laraamy16/Audio-Power-Amplifier/Layout/layout.jpg

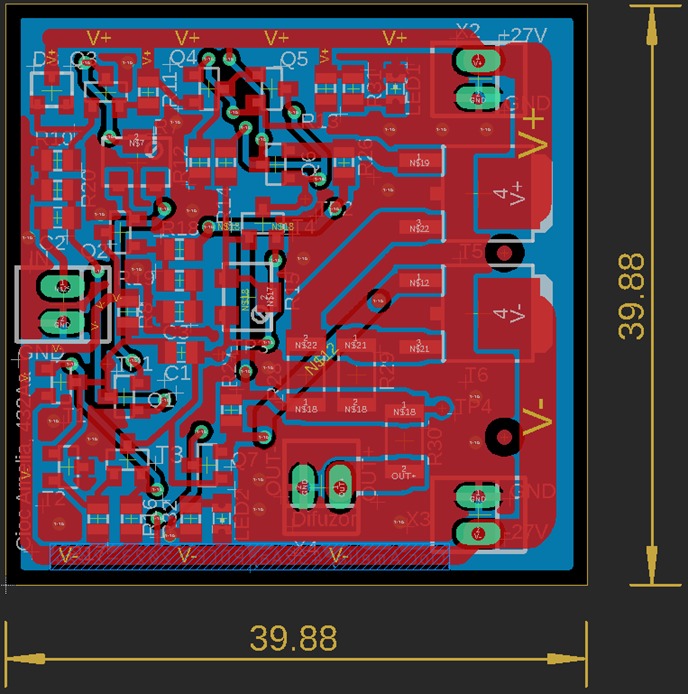
Layout/layout.jpg
