laraamy16/Audio-Power-Amplifier/Proiect docs/PCB.docx

Proiect Amplificator de putere

– Proiectare PCB cu componente SMD in EAGLE -

Cioc Amelia Gisele, Grupa 432Aa, PDCE I 2023-2024

Schema electrica amplificator de putere in Eagle:

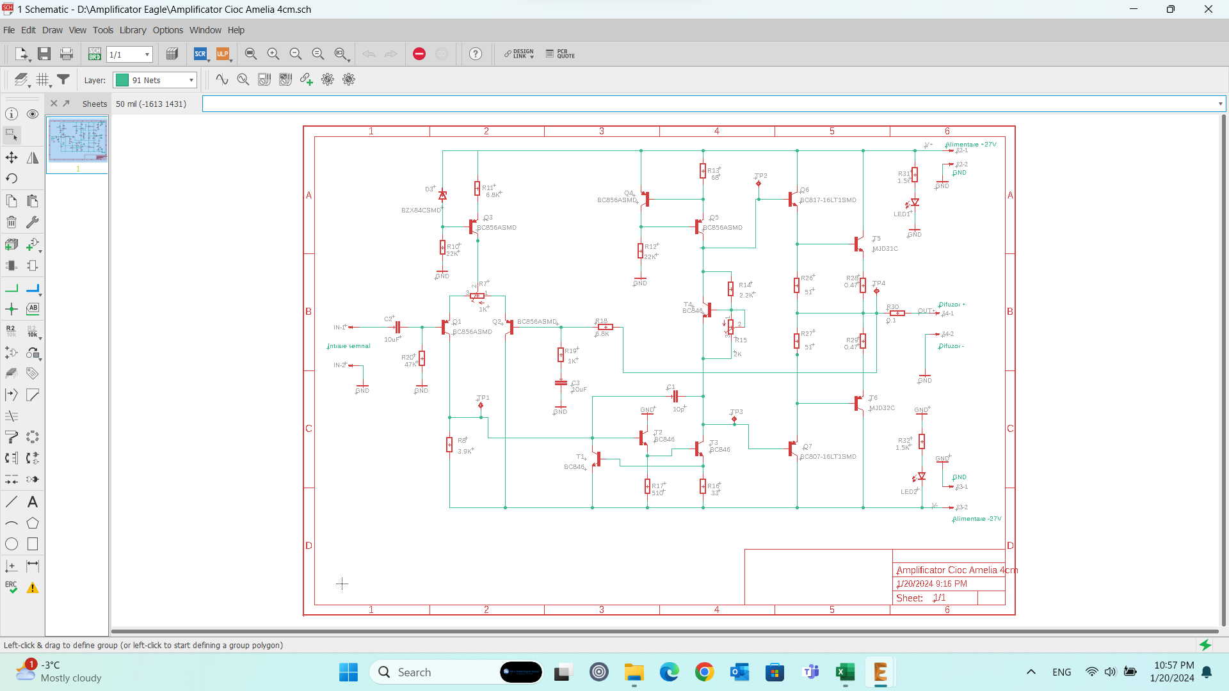
[picture p2: figure]

Schema electrica amplificator de putere

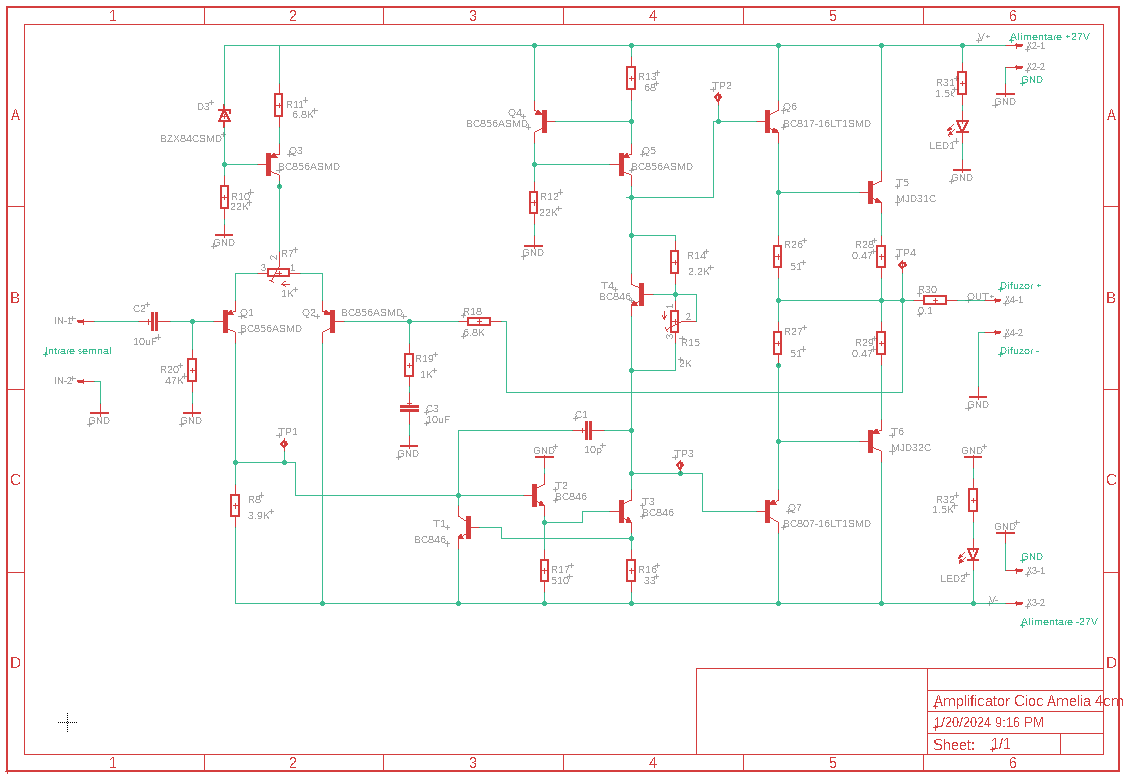
[picture p3: figure]

Rutare trasee PCB amplificator de putere in Eagle (dimensiuni in mm):

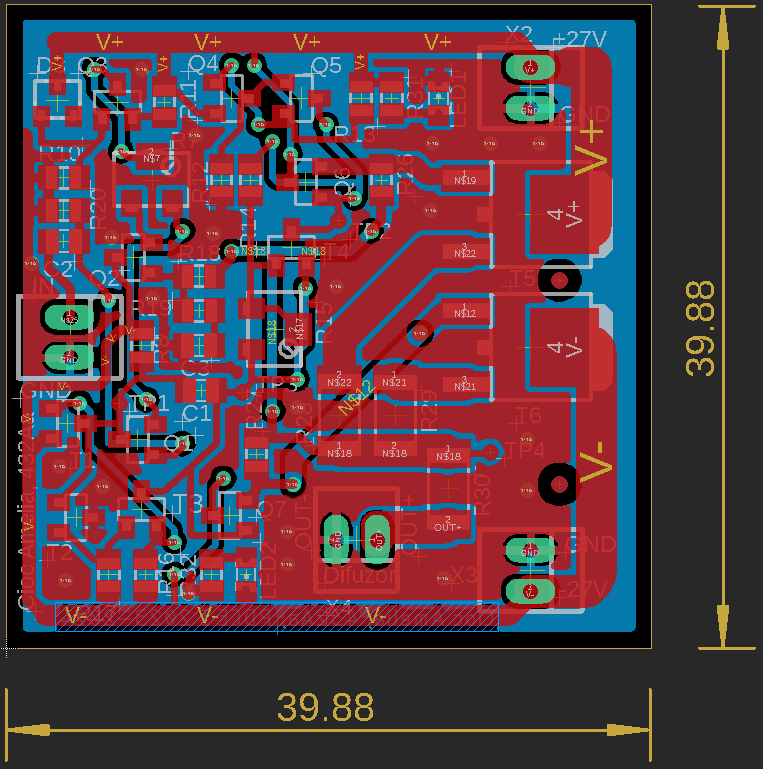
[picture p4: figure]

PCB amplificator - stratul top:

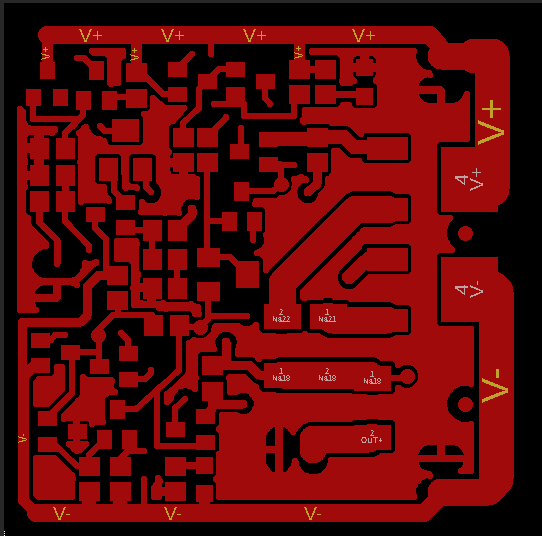
[picture p5: figure]

PCB amplificator - stratul bottom:

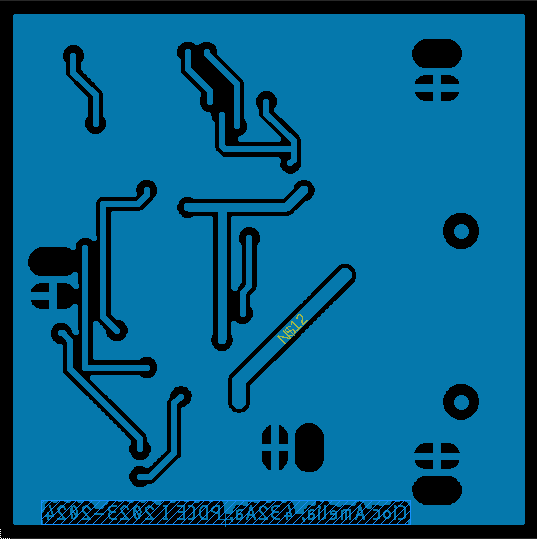
[picture p6: figure]
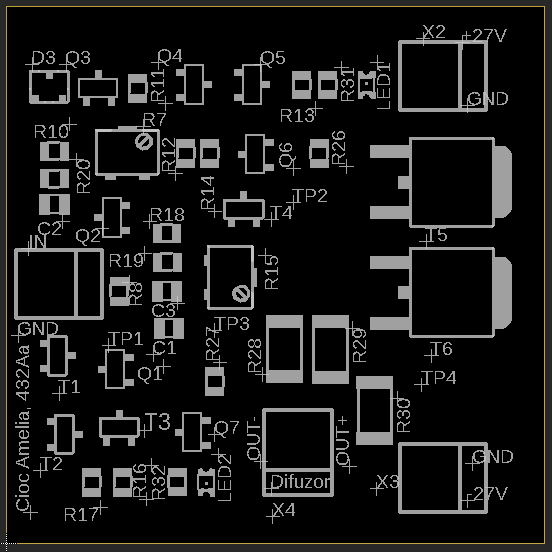
[picture p7: figure]

Amplasare si dimensiuni gauri si vias-uri

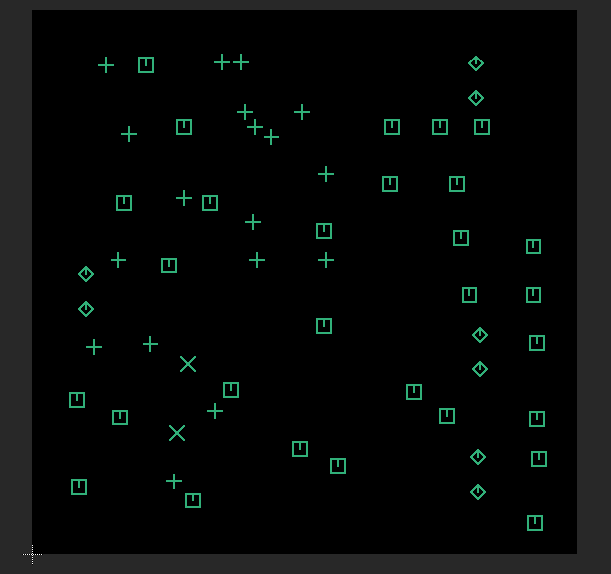
[picture p8: figure]
