laraamy16/Audio-Power-Amplifier/Tema2_N16_Amplificatorul_Audio_de_Putere.pdf

### Capitolul 2

### AMPLIFICATOR AUDIO DE PUTERE

Acest capitol prezintă principalele aspectele ale proiectării amplificatoarelor audio de putere. Se porneşte de la o temă de proiectare care stabileşte schema bloc a amplificatorului şi principalii parametri ai amplificatorului. După proiectarea etajului final, pilot, diferenţial, a protecţiei termice şi la scurtcircuit sunt analizate stabilitatea şi amplificarea stabilită de reţeaua de reacţie negativă.

### 2.1 TEMA DE PROIECTARE

Tema de proiectare se referă la un amplificator de audiofrecvenţă de mare putere realizat dintr-un etaj de ieşire în clasă B polarizat cu ajutorul etajului pilot care lucrează în clasă A. Pentru asigurarea unui curent mare de ieşire tranzistoarele finale sunt realizate din două tranzistoare în conexiune darlington.
Amplificarea în tensiune şi adaptarea cu sursa de semnal de intrare este realizată cu ajutorul etajului de intrare de tip diferenţial care lucrează de asemenea în clasă
A. Amplificarea globală a amplificatorului este stabilită prin intermediul reacţiei negative.

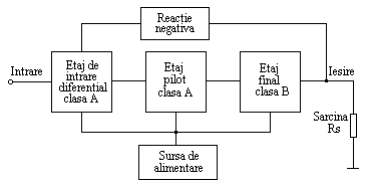
[picture p21: figure]

Figura 2.1-1. Schema bloc a amplificatorului audio de putere

24 | Proiectarea circuitelor electronice de audiofrecvenţă

### 2.2 SETURI DE DATE DE INTRARE

Principalii parametri ai amplificatorului audio de putere sunt:
- Puterea nominală pe sarcină PS (W)
- Rezistenţa de sarcină Rs (Ω)
- Rezistenţa de intrare Ri (KΩ)
- Amplificarea în tensiune AV (-)

Sursa de alimentare va asigura următorii parametri:
- Curentul maxim I0M (A)
- Rezistenţa de ieşire maximă R0M (Ω)
- Tensiunea de alimentare este 220Vac ± 10%

Tabelul 2.2-1. Seturi de date de intrare pentru proiectare
Nr. | Amplificator | Sursă de alimentare
PS (W) | Rs (Ω) | Ri (KΩ) | AV (-) | I0M (A) | R0M (Ω)
1 | 60 | 2 | 30 | 8 | 7,7 | 2,6
2 | 60 | 3 | 35 | 9 | 6,3 | 3,8
3 | 60 | 4 | 40 | 10 | 5,5 | 4,9
4 | 60 | 5 | 45 | 11 | 4,9 | 6,0
5 | 50 | 3 | 30 | 12 | 5,8 | 3,9
6 | 50 | 4 | 35 | 8 | 5,0 | 5,0
7 | 50 | 5 | 40 | 9 | 4,5 | 6,1
8 | 50 | 6 | 45 | 10 | 4,1 | 7,2
9 | 40 | 4 | 30 | 11 | 4,5 | 5,1
10 | 40 | 5 | 35 | 12 | 4,0 | 6,3
11 | 40 | 6 | 40 | 8 | 3,7 | 7,4
12 | 40 | 7 | 45 | 9 | 3,4 | 8,5
13 | 30 | 5 | 30 | 10 | 3,5 | 6,4
14 | 30 | 6 | 35 | 11 | 3,2 | 7,6
15 | 30 | 7 | 40 | 12 | 2,9 | 8,7
16 | 30 | 8 | 45 | 8 | 2,7 | 9,8
17 | 20 | 6 | 30 | 9 | 2,6 | 7,9
18 | 20 | 7 | 35 | 10 | 2,4 | 9,1
19 | 20 | 8 | 40 | 11 | 2,2 | 10,2
20 | 20 | 9 | 45 | 12 | 2,1 | 11,4

Amplificator audio de putere | 25

Setul de date utilizate pentru exemplificare

Pentru proiectarea etajelor amplificatorului audio de putere a fost utilizat setul de parametri următor:

Tabelul 2.2-2. Setul de date utilizate pentru exemplificare
Nr. | Amplificator | Sursă de alimentare
PS (W) | Rs (Ω) | Ri (KΩ) | AV (-) | I0M (A) | R0M (Ω)
3 | 60 | 4 | 40 | 10 | 5,5 | 4,9

### 2.3 ETAJUL FINAL

Este realizat cu două tranzistoare bipolare complementare în conexiune colector comun. Deoarece tehnologia bipolară este axată pe tranzistore de putere de tip npn şi pentru creşterea amplificării în curent a etajului final se utilizează pentru cele două tranzistoare finale de putere configuraţii darlington de tip npn şi pnp.

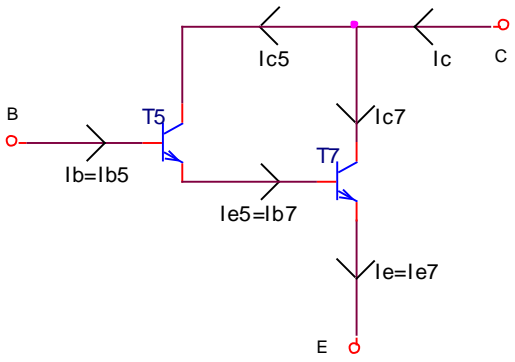
[picture p22: figure]

Figura 2.3-1. Configuraţie darligton de tip npn

Considerăm T5 şi T7 în regim activ normal RAN.

VBE = VBE5 + VBE7 > 0
>0 >0

VCE = VCE7 = VCE5 + VBE7 > 0

Pentru ICB0 = 0 =>

Ic= Ic5 + Ic7 = βF5 IB5 + βF7 IB7 = βF5 IB5 + βF7 IE5 =

=> RAN

26 | Proiectarea circuitelor electronice de audiofrecvenţă

=
I | I C

F

F
F | B | F | 5
7

7
5 | 5 | 7

1
β

β
β β

+
+ | =
I | F I B

F

F
F | B | F | 5 | 5
7

7
5 | 5 | 7
| | 1
β | β | β
| | β

β +
+ | =

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
æ | +
+
| 7

7
5 | 5 | 7

1
1

F

F

F I B | F | β β
β | β | =
÷

÷
ø

ö
ç

ç
è
æ | +
+
| 7

7
5 | 7

1
1

F

F
F I B | F | β

β
β | β

÷

÷
ø

ö
ç

ç
è
æ | +
= | = | +

7

7
5 | 7

1
1

F

F
F | F
B

C
F
I

I
β

β
β | β | β | ≈ β ( β ) 5 | 7
1
F | F
+ | ≈ β F5 β F7
·

Principalii parametri ai configuraţiei Darlington de tip npn sunt:

βF ≈ βF7 βF5 = mare | avantaj

I

V V
I

V
h

B

BE | BE

B

BE

5

5 | 7
11

+
= | = | = h11T 5 + (1+ β F5

)h11T 7
= mare | avantaj
VCE, Saturaţie = VCE7, Saturaţie = nu se modifică | avantaj
VBE = 2VBE5 = 2VBE7 = mare | dezavantaj

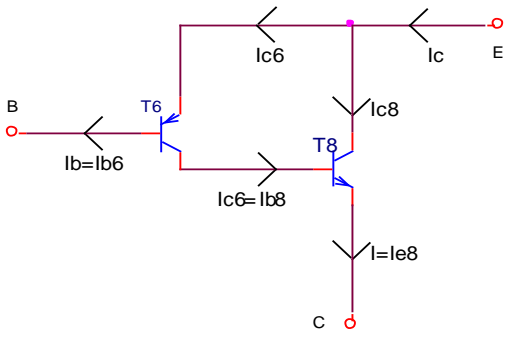
[picture p23: figure]

Figura 2.3-2. Configuraţie darligton de tip pnp

Considerăm T1 şi T2 in RAN.

VEB = VEB6 > 0

VEC = VCE8 = VEC6 + VBE8 > 0

Pentru ICB0 = 0 =>

IC = IE8 = ( βF8 + 1 ) IB8 = ( βF8 + 1 ) IC6 =

= ( βF8 + 1 ) βF6 IB6 = ( βF8 + 1 ) βF6 IB

=> RAN

Amplificator audio de putere | 27

βF =

B

C
I

I
= ( βF8 + 1 ) βF6 ≈ βF8 βF6

Principalii parametri ai configuraţiei Darlington de tip pnp sunt:

βF ≈ βF8 βF6 = mare | avantaj
h11 = h116 = nu se modifică | avantaj
VEB = VEB6 = nu se modifică | avantaj
VEC = VCE8 = VEC6 + VBE8 = mare | dezavantaj

Când T6 se saturează se pierde controlul lui IC6 prin IB6 iar IC6 se închide prin joncţiunea BE a lui T8 care rămâne în RAN. =>

VEC, Saturaţie = VEC6, Saturaţie + VBE8 = 0,2 + 0,6 = 0,8V

Tehnologia bipolară standard este orientată pe fabricarea tranzistoarelor de tip npn care au conducţie verticală şi au factorul de amplificare în curent βF = mare (100 ÷ 200). Tranzistoarele pnp sunt de tip lateral cu conducţie orizontală sau tranzistor de substrat cu conducţie verticală având βF mic.

În practică se folosesc configuraţiile darlington cu rezistenţă în paralel cu joncţiunea bază-emitor a tranzistorului bipolar de putere de tip npn (R26 şi R27). Rolul acestor rezistenţe este următorul:
- La funcţionarea în clasă „B” în repaus curentul prin T7 este mic iar curentul de baza va fi şi el mic. La curenţi mici de colector pentru T5 amplificarea în curent a tranzistoarelor are o cădere pronunţată Þ amplificarea este redusă Þ reacţia negativă va fi ineficientă asupra neliniarităţii curbei de transfer.
- La îmbinarea caracteristicilor tranzistoarelor complementare apar distorsiuni de trecere (cross-over) şi pentru micşorarea acestora se face o polarizare iniţială în regim static al tranzistoarelor. Rezistenţa R26 măreşte curentul de colector al tranzistorului T5 în regim de repaus deoarece la IC7 mic, h11,T7 e foarte mare şi cea mai mare parte a curentului dat de T5 trece prin R26 şi astfel T5 lucrează la curenţi acceptabili cu βF5 suficient de mare. La curent de colector mare pentru T7, h11T7 scade exponenţial şi R26 se poate neglija.
- Rezistenţa R26 permite evacuarea sarcinii stocate prin circulaţia unui curent invers de bază în perioada corespunzătoare blocării Þ R26 îmbunătăţeşte funcţionarea la frecvenţe înalte, dar nu elimină efectele dacă frecvenţa de lucru e mai mare ca fβ.

28 | Proiectarea circuitelor electronice de audiofrecvenţă

Puterea disipată de tranzistorii finali T7,T8

Puterea maximă ce se poate obţine la ieşire este:
C CM P = E · I
0
EC este tensiunea de alimentare pentru un tranzistor final ICM este curentul de colector maxim al tranzistorilor finali

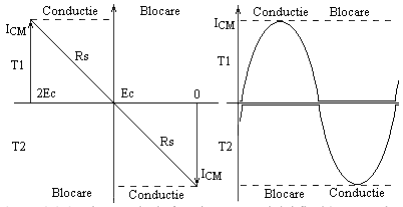
[picture p24: figure]

Figura 2.3-3. Diagramele de funcţionare a etajului final în contratimp

Puterea absorbită de la sursa de alimentare este:
a | C | med P = 2E · I
Imed este curentul mediu absorbit de la sursă
Imed = | ò
·

/ 2

0

2

sin 1

T
CM | tdt
T | T
k | I

π
= k
π

I CM

k este factorul de utilizare a tensiunii de alimentare

0 | 636 | 0 0,

2
2 | 2 | P | k P
I | k
P | E | I | E | k

CM
a | C | med | C = | · | = | · · | = | · | = | · ·
π | π
Puterea nominală pe sarcină are expresia:

0

2 | 2 | 2 | 2
0,5
2

1
( )
2

1
PS

= · RS

- k · ICM

= · RS

- k · I CM = · k · P

RS este rezistenţa de sarcină

Puterea disipată de tranzistorii finali este:

0

2
( | )
(0,636 | 0,5 )
7 | 8

Pd T +T

= Pa − Pu

= | k − | k · P

Randamentul

| | k
| k P
k | P
P

P

a

S
= ·
- ·
- ·
= | = | 0,785
0,636

0,5

0

0

2
η

Derivând expresia puterii disipate de tranzistorii finali în raport cu k Þ puterea disipată maximă pe tranzistorii finali

Pd max(T 7+T8)
la k=0,636.

Pentru

k = 0,636
Þ

Amplificator audio de putere | 29
0 | 0
2 | 2 Pd max(T 7+T8) = [0,636 − 0,5·(0,636) ]· P = 0,2· P

Pentru un singur tranzistor final

0

2
max 7, 8
(0,636 | 0,5 | )
2

1
Pd | T T
= · | · k − | · k · P
, pentru k=0.636 Þ
max 7, 8 | 1 0 Pd | T T
= 0,
- P

Dimensionarea componentelor etajului final

Pentru dimensionarea componentelor etajului final se impun condiţiile:
- Puterea nominală pe sarcină PS la o frecvenţă convenabilă, respectiv 1kHz (din setul de date utilizate pentru exemplificare PS =60)
- Impedanţa de sarcină nominală la 1kHz are caracter predominant rezistiv RS (din setul de date utilizate pentru exemplificare RS =4Ω)
1. Determinarea valorilor de vârf ale curentului şi tensiunii pe sarcină

A
R

P
I
I | R | I V
P

S

S
S
S | S | S | S
S | 5,4
4
2 | 2 60
2 | 2

2
=

·
=
- Þ =

·
=

·
=

VS = RS

·I S= 4Ω·5,4A = 21,92V ≈ 21,6V

2. Se admite o pierdere de putere de maxim 10% pe rezistenţele de emitor R28 şi

R29

R28 = R29 = 0,39Ω
< 0.1 X 4Ω
toleranţă

±
5%

Căderea maximă de tensiune pe R28,R29 este
VR | VR | R28 | I
S | 2,1V
28 | 29
= | = | · | =

W

I V
P
S | R
dR | R | 2,9
4

28
28, 29 | =

·
= | (valoare medie, T7,T8 lucrează

în clasă B). Se aleg R28 şi R29 de 3W.

3. Se alege rezistenţa pentru circuitul de protecţie la suprasarcină

R30 = 0,1Ω

VR30 = R30

·I S = 0,5V

W

I V
P
S | R
dR | 1,5
2
| 30
30 | =

·
=
Se alege R30 de 2W.

30 | Proiectarea circuitelor electronice de audiofrecvenţă
4. Se aleg tranzistorii finali

S-a optat pentru tranzistori finali bipolari de putere de tip BDY 26 (183T2) având următorii parametri:

Ptot

= 87,5W

| VCE0,VCER = 180V | IC = 6A
h21E= 20÷180 (la IC=2A) | VBE < 1V | VCES = 0,6V
fTmin < 10MHz

Ptot este puterea totală disipată
VCE0 este tensiunea colector emitor cu baza în gol
VCER este tensiunea colector emitor cu rezistenţă specificată între bază şi emitor
IC este curentul de colector
h21E este factorul de amplificare în curent static în conexiunea emitor comun
VBE este tensiunea bază emitor
VCES este tensiunea colector emitor în saturaţie
fTmin este frecvenţa de tăiere minimă
5. Verificarea la străpungere a tranzistorilor finali

EC ≤ 0,9VCER , EC = 27V ≤ 162 = 0,9 VCER

6. Determinarea tensiunii reziduale pe darlingtonul npn

Vrez = VCEST5 + VBET7max
În cazul cel mai defavorabil:

mA

I | I | A
I
| T T

S

T T

CT T
T T | BT T | 270
20

5,4
20
7, 8 | 7, 8

7, 8
7, 8 = | Þ | 7, 8 = | = | = | =
β | β

β

În funcţie de IBT7,T8 se aleg T5 şi T6 (BD 139, BD 140) Pentru BD 139, VCEST5 ≈ 0,5V Þ Vrez = 0,5 + 1 = 1,5V

7. Determinarea tensiunii de alimentare

EC ≥ VS + VR30 + VR28 + Vrez = 25,7V = EC’ Se alege EC = 27V > EC’

8. Calculul energetic al tranzistorilor finali

P0 = EC

·ICM = EC

·I S =145W

0,95
27

25,7

'
= | = | =

C

C
E

E
k

Amplificator audio de putere | 31

Pa

= 0,636· k · P0 = 87,6W

PS

k | P | 65,4W
2

1

0

2
= · | · | =

Pd = Pa − PS = 22,2W

(Puterea disipată pe T7 si T8 )

Puterea disipată pe un tranzistor final este maximă pentru k=0,636 este

Pd max T7

= Pd max T8

= 0,1· P0 =14,5W
În cazul nostru pentru k=0,95 puterea disipată pe un tranzistor final este PdT7,T8 = 0,5 ( 0,636k – 0,5 k²
) P0 = 11W
η = 0,785· k = 0,75

9.Dimensionarea rezistenţelor R26 ,R27

Se aleg R26 ,R27 = 39Ω, toleranţă

±
5%

ICMT5 = IBMT7 + IR26 = IBMT7 +
R

V BEMT

26

7
= 270mA +
39Ω

1V
≈ 300mA

ICMT5 este curentul de colector maxim al tranzistorului T5 IBMT7 este curentul de bază maxim al tranzistorului T7 VBEMT7 este tensiunea bază emitor maximă a tranzistorului T7

10. Estimarea sarcinii dinamice pentru T5,T6

RST5 = [ h11T7 + βT7 ( RS + R30 + R28 ) ] ║
R26

h11T7 =

7

7

BT

BEMT
I

V
≅ 3,3 Ω

RST5 = ( 3,3 + 20 · 4,49 ) ║ 39 = 27,5 Ω

11. Calculul energetic al tranzistorilor complementari

P0 = ICMT5 · EC = 0,3 · 27 = 8,1W

Pd max

= 0,1P0 = 0,81W
Tranzistoarele BD 139 şi BD 140 corespund, având următorii parametri:
VCE0 = 80V | IC =1A | Ptot= 12,5W
VCER = 100V | ICM =1,5A | fT = 50MHz
VEB0 = 5V | IB =0,2A | Rthj-C ≤ 10°C
h21E = 50÷200 | Tj =150°C

32 | Proiectarea circuitelor electronice de audiofrecvenţă
12. Calculul frecvenţei de tăiere

ωT

= β 0
·ωβ Þ
Pentru T7 şi T8 | f ≥100 ÷500kHz β
Pentru T5 şi T6 | f ≥ 0,35 ÷1,25MHz β

### 2.4 ETAJUL PILOT

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
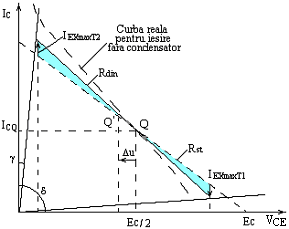
[picture p25: figure]

Figura 2.4-1. Configuraţia | Figura 2.4-2. Caracteristica de ieşire
etajului pilot | a etajului pilot

Etajul pilot, conform cu Figura 2.4-1. este de tip emitor comun EC şi lucrează în clasă A. Pentru utilizarea completă a sursei de alimentare a circuitului de putere este necesară o tensiune de excitaţie vârf la vârf mai mare ca tensiunea de alimentare Vex,vv > EC, condiţie greu de realizat.
În figura 2.6
Rsat tgγ = şi

Rrez tgδ =
, definite în raport cu ICER. Se observă că în cazul real excursia tensiunii Vex,vv este mult mai mică decât EC şi asimetrică.
K1 şi K2 sunt coeficienţii de utilizare ai tensiunii de alimentare pentru tranzistorul T1 respectiv pentru tranzistorul T2.
În schemele cu ieşire pe condensator, datorită inegalităţii dintre K1 şi K2 (în general K1 < K2) apar distorsiuni la nivele mari şi apare o componentă continuă (Δu) ce deplasează punctul static de funcţionare (PSF-ul) în sensul egalizării factorului de utilizare, Figura 2.4-2.. În schemele în care ieşirea nu se face pe condensator, ca în cazul acestui proiect, apare o curbură a caracteristicilor. Soluţia poate fi folosirea unei tensiuni de alimentare a etajului pilot

Ep > Ec
, fapt
ce conduce la complicarea sursei de alimentare sau la soluţia de bootstrapare a rezistenţei RC.

Amplificator audio de putere | 33

Ec /2

Rs

Ec /2

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
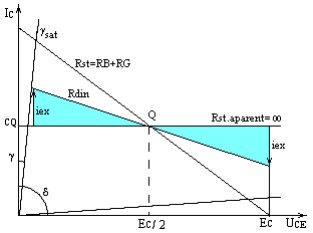
[picture p26: figure]

Figura 2.4-3. Bootstraparea | Figura 2.4-4. Caracteristica de ieşire
rezistenţei de colector a etajului pilot | a etajului pilot bootstrapat

Pentru acest montaj se poate considera:
- În regim static rezistenţa de alimentare este

Rst

= Rc

= RB + RG
- În regim dinamic ZS pentru etajul pilot este Rdin.
- În regim dinamic rezistenţa aparentă de alimentare este Rst a = ∞ şi sursa are

valoarea

E C = ∞

'

Avantajele utilizării acestei soluţii sunt următoarele:
- Excursia curentului se limitează la
VV | ex | CQ I | = 2· I < 2· I
- Deoarece
CQ | ex I | > I
, această soluţie este avantajoasă pentru uşurarea regimului termic al etajului pilot.
- Se obţine astfel
1 | | | 2

k ≈ k

Condiţia de funcţionare a schemei este ca rezistenţa dinamică Rdin > RC = RB + RG

Dimensionarea componentelor etajului pilot

1. Se calculează curentul de excitaţie maxim

mA

I | mA I | I

T

CT
ex | BT | 6
50

300

min

max
max | max

5

5

5

= | = | = | =
β

Se pot neglija curenţii reziduali şi se alege

ICT3 = ICQ

= 8mA
>

I ex max

= 6mA

34 | Proiectarea circuitelor electronice de audiofrecvenţă
2. Rezistenţa statică de alimentare
= | + | = | + | = | = | = | KΩ
mA

V
I

E
R | R | R | R | R

CT

C
C | B | G | 3,375
8

27

3

13 12

Alegem

R12 = 360Ω
si

R 3k 13 =

3. Sarcina dinamică a pilotului

( ) 30

11

'
13

13
21
13 | 11
13 | 11

6
6

6
1 | R | R
R | h

R
h
R | h
R | h
R | S

T

E
T

T
din | f

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
+ | + | ·
+

·
≈

unde h11T6 =
40 8

40

6

6
·

=
gmT

β T
= 125Ω şi

h21Ef = h21T6 · h21T8 = 50 · 20 = 1000

( | ) 11 | 21 | 29 11
'
1

6

h 6 | h | h | R T | Ef
T = | + + | ·
= 125 + ( 1+1000 ) · 0,39 = 515Ω

Þ

÷· | ≈ | Ω
ø

ö
ç
è

æ
+ | + | ·

·
Rdin = | 4,1 3,6K
3,515

3
1 1000
3125

3000 125

Se verifică

Rdin = 3,6kΩ > RB + RG = 3,36KΩ

4. Tensiunea minimă pe tranzistorul pilot

Vpmin =VBE min,T8 +VCEmin,T 6

= 0,6 + 0,2 = 0,8V

5. Alegerea tranzistorului pilot

Pentru o funcţionare cât mai bună a bootstrapului se alege un tranzistor cu VCEsat şi ICER mici.
Se alege BD 139 cu parametri:
VCE0 = 80V | IC =1A | Ptot= 12,5W
VCER = 100V | ICM =1,5A | fT = 50MHz
VEB0 = 5V | IB =0,2A | Rthj-C ≤ 10°C
h21E = 50÷200 | Tj =150°C

La IC = 2·ICQ = 16mA → VCesat = 0,6V şi ICER = 0,2mA

Tensiunea ce trebuie preluată de R15 este

Amplificator audio de putere | 35
= | − | = | − | = | Þ | ≅ | = | = 25Ω
8

0,2
0,8 0,6 0,2

15
15 | min | , 3 | 15 | mA

V
I

V
V | V | V | V | R

CQ

R
R | p | CEsat T

Calculele impun alegerea lui R15 = 27Ω cu toleranţă de 5%

6. Curentul de baza al tranzistorului T3

Considerând h21E mediu,T3 = 100 Þ

A

mA IBT | 80µ
100

8
3 = =
7. Verificarea funcţionării la semnal mic
= | = | =

CQ

ex

m

C
BE | I

I
g

I
40

µ
0,024V =24mV < 26mV =
q

KT

8. Amplificarea în tensiune a etajului pilot

Etajul pilot este de tip emitor comun cu sarcină distribuită având amplificarea în tensiune:

133
27

3,6

15

= −
Ω

≈ − = −

k
R

R
A

din
vp
9. Calculul frecvenţei de tăiere

ωT

= β 0
·ωβ Þ | f | MHz T | 0,35...1,25
3 β | ≥
10. Calculul circuitului de polarizare al tranzistorilor finali

Circuitul de polarizare este alcătuit din tranzistorul T4 (superdiodă) şi potenţiometrul R14. Se consideră necesar pentru deschiderea tranzistorilor finali o tensiune de 2 × 0,7V.
Pentru tranzistorul T4 alegem tipul BC 107A având următoarele valori limită absolute:
VCE0 =50V | IC = 100mA | IB = 50mA
Ptot = 300mW | | | Tj = 175°C

În PSF tranzistorul T4 are următorii parametri:

IC,T 4 = 8mA | VCE,T 4 ≅ 1,4V | A

mA
h

I
| | | I

E T

C T
B T | 36µ
220

8

21 , 4

, 4 Þ , 4 = | ≅ | =

36 | Proiectarea circuitelor electronice de audiofrecvenţă

Se alege prin divizorul de bază curentul:

≅ | >> | Þ | = | + | = | = | kΩ
mA

V
I
d | mA | I B T | R | R | R | 2,8
0,5

1,4
0,5 | , 4 | 14 | 1 | 2

Se alege R14 = 2,5kΩ.

### 2.5 ETAJUL DIFERENŢIAL

Etajul diferenţial este alcătuit din două tranzistoare în conexiune EC care lucrează în clasă A şi sunt cuplate diferenţial. Componentele acestui etaj sunt următoarele:
- Tranzistoarele T1 ,T2
- Rezistentele R6, R8, R9, R11, R31 şi D1, R7

Principalele funcţii ale acestui etaj sunt:
- Obţinerea unei impedanţe de intrare convenabile.
- Reglează echilibrarea stării de repaus (în absenţa semnalului) a întregului amplificator de putere
- Permite cuplarea reţelei de reacţie negativă

Dimensionarea componentelor etajului diferenţial

1. Alegerea tranzistoarelor T1,T2

Tranzistoarele T1, T2 se aleg de tipul BC178 şi se împerechează (se sortează două tranzistoare cu caracteristici cât mai apropiate). Aceste tranzistoare au următoarele valori limită absolute:
VCE0 =30V | IC = 100mA | IB = 50mA
Ptot = 300mW | Tj = 175°C
2. Dimensionarea rezistenţei de colector a tranzistorului T1 (R11)

Se alege

RCT1

= R11 < ZinT3min ZinT3min | h11eT3 min | h21eT3
R15 = | + | ·

IB,T3max ≅
h

CT I

21Emediu,T3

2 3
=
100

2 ·8
= 160µA
IC,T3min ≅ IB,T3max = 160µA | Þ

gm,T 3min
= 40 · IC,T3min = 6,4 Þ

h11,T3min =
g m T

T

, 3min

β 3min
=
6,4

50
= 7,8K ≅ 8K

Amplificator audio de putere | 37

Þ

ZinT3min | h11eT3 min | h21eT3
R15 = | + | ·
= 8K + 100·0,027K ≅ 11K

Pentru polarizarea bazei lui T3 trebuie ca :

, 1 | , 3 | 11 | 3 | 15 ( | ) C T | B T | R | VBET | VR
I | − I | · | = | +
≅ 0,7V + 8mA·27Ω ≅ 0,92V

Din motive de zgomot, pentru a avea factorul de zgomot F = 3dB trebuie ca:

ICT1 ≤ 300µA | Se alege ICT1 = ICT2 = 250µA

Þ

K
mA

V
I I

R

C T | B T

5,4
170

0,92
250 80
0,92 | 0,92
, 1 | , 3
11 | = | =
−

=
−

≈

Se alege R11 = 5,6K cu toleranţă de ±5%.

3. Verificarea funcţionării la semnal mic

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
BE T | 8
40 250 | /

80
40 , 1

, 1

, 1

, 1
, 1 | =
·

=
·

= =
µ

µ

4. Determinarea tensiunii stabilizate de D1

Pentru a simula generatorul de curent din emitor trebuie ca tensiunea stabilizată VZ

>> vBE,T1.
Deoarece
BT1

I
e foarte mic, se poate neglija tensiunea între bază şi masă UR6.

Practic

Vz

=VR8 +VBE,T1 +VR6 ≈VR8 +VBE,T1

Pentru ca R8 să se comporte ca un generator de curent continuu trebuie ca VR8 = ct, dar VBE,T1 variază cu vBE,T1 Þ tensiunea stabilizată de diodă trebuie să fie mult mai mare ca tensiunea bază emitor a tranzistorului T1, VZ >> vBE,T1.
Se alege VZ = 8,2V, astfel VZ ≅ 1000 · vBE,T1
Pentru tranzistorul T1 curentul de colector şi tensiunea colector emitor au valorile: IC,T1 = 250µA şi

VCE ≈ EC

= 27V .

5 Dimensionarea rezistenţelor R6, R31

Se alege R6 =R31 =39kΩ, ±2% având în vedere că în jurul acestei valori se va situa Zintr a întregului amplificator.

6 Dimensionarea rezistenţelor R9, R8

Pentru BC178B din catalog se obţine h21E =240 Þ

A

A
I B T | µ

µ
| 1
240

250
, 1 = | ≈ | .

38 | Proiectarea circuitelor electronice de audiofrecvenţă

Þ

VR 40mV

6

=
. Considerând

VBE,T1 ≈ 0,6V

Þ

V | VR | Vz | VBE T | VR | V
R
| | | | | 7,56
| 8 | | 1 | 6
| | | ,
9
2
1 | + | = | − | − | =

Se alege pentru R9 o valoare de 500Ω şi atunci căderea de tensiune suplimentară pe jumătate din rezistenţa din emitorul lui T1 este :

, 1 | 9
9
2

1
2

1
V | IC T | R
R
≈ | · · | =62,6mV | Þ VR8 ≅ 7,5V

Curentul prin rezistenţa R8 este suma curenţilor de colector ai tranzistorilor T1, T2

IR8 = 2IC,T1 = 500µA Þ

K

| | | mA V
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
8 = | = | =
Ω, ±5%
6. Polarizarea diodei D1

Alegem o diodă zener de tipul PL 8,2V care pentru o funcţionare normală trebuie polarizată la Iz =5mA.

R7 =
mA
V | V
I | I
E | V
z | R
C | z
5,5

27 8,2

8

−
=
+

−
= 3,42KΩ

Se alege R7 = 3,3KΩ, ±5%

7. Determinarea amplificării etajului diferenţial

Amplificarea etajului diferenţial poate fi aproximată astfel:

9
2

1
R

R
A

Sdif
vdif ≅ −

unde RSdif este rezistenţa de sarcină a diferenţialului

= Ω

+

·

=

+

·

= | = | k
K | K
K | K
R | Z
R | Z

R

in T

in T

in T
Sdif

R Z
1,8
2
5,6 | 10
5,6 | 10
2 | 2
11 | , 1
11 | , 1
11 | , 1

Þ
0,25

1,8
Avdif ≅ − = -7,2 ≅ -7

### 2.6 REACŢIA NEGATIVĂ

Se apreciază un factor de transfer pe bucla de reacţie optim la frecvenţe medii:

Amplificator audio de putere | 39

10

1

10 | 31
10 | ≈
+

≈
R R

R
βr
(grad de reacţie

≈ 20dB
)

Datorită divizărilor introduse de protecţia termică, tensiunea reală de intrare pe diferenţial este:

Vin,dif = D1 · D2 · Vgen

Unde: D1 =
R R

R

6 5

6
+
= 0,95 | D2 =
| ( | | )
R | [R | (R | R )]
R | R | R
1 | 2 | 5 | 6
| 2 | 5 | 6
+ | +
| | +
= 0,89
Se alege pentru Vgen = 1,5Vef | Þ
Uin dif | 3Vef 0,95 0,89 1,5 1,
,
= | · | · | =

Tensiunea nominală de ieşire este :

Vn =

( )

2

I S RS + R30 ·
= 0,7· IS· (RS + R30 ) = 0,7 · 5,4A · (4 + 0,1)Ω = 15,5V

Amplificarea cu reacţie este AVr =

in dif

n
V

V

,

=
1,3

15,5
= 12 =
R
R | R
| 10

10 + 31
= 1+
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
= 11

Deoarece amplificarea în tensiune în buclă deschisă a amplificatorului de putere este dată de etajul pilot şi etajul diferenţial

Av

≈ Avp

- Avdif = −126·(− 7) = 882

Practic

r

Avr β

1
≅
Þ R10 ≅

= Ω

Ω
= | K
R | K
3,55
| 11

39
11

31

Se adoptă R10 = 3,3KΩ, ±5%

Frecvenţa limită pentru T1 şi T2 este fβ ≥ 400 ÷ 800KHz

### 2.7 STABILITATEA

Datorită complexităţii schemei nu se poate calcula curba de răspuns datorită numărului mare de tranzistori cu fT diferită. Datorita lui C3, βr este complex. Soluţia cea mai bună este evitarea zonelor de variaţie rapidă a fazei prin dispersarea, cât este posibil, a fT a diverselor circuite.

1. Stabilitatea la frecvenţe joase

Capacităţile ce intervin la frecvenţe joase sunt C1, C2, C3 şi C4

40 | Proiectarea circuitelor electronice de audiofrecvenţă

C2

Vo

C1

Vg
R1 | R2

Rg

Figura 2.7-1. Circuitul echivalent pentru polii daţi de C1 şi C2

C1 şi C2 introduc un zero de multiplicitate doi în origine şi un pol de gradul doi. Funcţia de transfer este următoarea:

1 | [ ( | ) | ( | )] | C | ( | )
1 | 2 | 1 | 2 | 1 | 2

2
1 | 1 | 2 | 1 | 2
1 | 2 | 1 | 2

2
0
g | g | C R R | R Rg | R Rg
s C R | R | C R | R | s

s C C R R
V

V
+ | + | + | + | + | + | +

=

Polul apare la frecvenţa:

( | )

1

1 | 2 | 1 | 2 | 1 | 2

0
C C R R + R Rg + R Rg

ω =

Dacă alegem C1 = C2 = 4,7µF şi considerând pentru adaptare Rg = 39KΩ, atunci avem
ω0 = 2,8Hz şi f0=0,45Hz

C3 introduce un pol şi un zero. Se alege pentru polul dat de C3 frecvenţa cea mai mare.
Se alege C3 = 10µF şi rezultă:

τ 3 p

= C3R10 = 0,036
Þ
f | Hz

p

p | 4,4
2

1

3

3 | = | =
πτ

τ 3z

= C3

(R10 + R21) = 0,366
Þ
f | Hz

z

z | 0,44
2

1

3

3 | = | =
πτ

Pentru C4 se alege o frecvenţă a polului de 1Hz

Þ

F
f R

C

dinpilot

µ
π | π

44,2
2 3,6 10

1
2

1

3
4
4 | =
- ·

=
·

=

Se adoptă

C4 = 47µF /35V

Amplificator audio de putere | 41

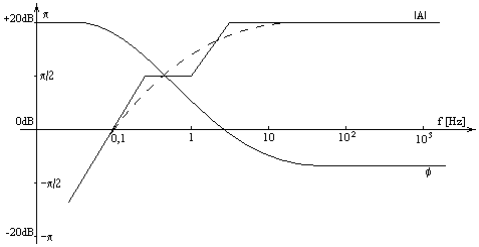
[picture p27: figure]

Figura 2.7-2. Amplitudinea şi faza amplificatorului în funcţie de frecvenţă

Deoarece condiţiile

A ≥ 1
şi

0 φ < 180
sunt îndeplinite la frecvenţe joase, amplificatorul va fi stabil.
2. Stabilitatea la frecvenţe înalte

Pentru analiza stabilităţii la frecvenţe înalte se face diagrama repartiţiilor frecvenţelor de tăiere fT a tranzistoarelor.

Figura 2.7-3. Distribuţia frecvenţelor de tăiere a tranzistoarelor

Se apreciază ca dificilă zona de la 500kHz unde se pot suprapune frecvenţele de tăiere a trei tranzistoare T3, T5, T6. La realizarea experimentală dacă apar oscilaţii se acţionează printr-o reacţie locală asupra lui T3.

### 2.8 PROTECŢIA TERMICĂ

Protecţia termică acţionează la încălzirea tranzistorilor finali prin limitarea amplitudinii semnalului de intrare. Circuitul de protecţie termică este alcătuit din următoarele componente:
- Tranzistorul T13
- Rezistenţele R1, R2, R4 şi termistorul R3
Rezistenţa R5 s-a ales de 2,2kΩ pentru a nu apare cuplarea direct la masă a bazei lui T1, în cazul unei defecţiuni a tranzistorului T13.

42 | Proiectarea circuitelor electronice de audiofrecvenţă

Principiul de funcţionare se bazează pe cuplarea termică cu tranzistorii finali, a termistorului R3 (Th40KΩ) care astfel monitorizează temperatura de funcţionare a acestora. La temperatura ambiantă R3 are valoare mare astfel încât divizorul format din R3-R4 menţine tranzistorul T13 blocat. La creşterea temperaturii valoarea rezistenţei termistorului R3 scade şi tinde să deschidă tranzistorul T13 care va şunta intrarea, reducând amplitudinea semnalului de intrare şi astfel a semnalului de pe tranzistorii finali.
Se alege R3 cu rezistenţa nominală Rnom = 40kΩ şi care la 100°C are rezistenţa ≅ 2,3kΩ.
Se alege temperatura de 100°C a tranzistorilor finali ca prag de acţiune a protecţiei termice. Pentru ca R2 să nu modifice semnificativ impedanţa de intrare Zintrare se alege de valoare mare R2=120kΩ, ±5% aceasta limitând curentul de colector al tranzistorului T13 la valoarea:
| A k

V
R

V
I

z
C T | 68µ
120

8,2

2

, 13 ≤ | = | =

Din caracteristica de transconductanţă (IC, VBE) se apreciază pentru IC,T13 = 68µA
o tensiune bază-emitor:

VBE,T13 ≈ 0,5V
. Cu aceste date se poate
dimensiona rezistenţa R4 cu ajutorul ecuaţiei:

8,2

, 13 | 0,5
4 | 3

4
= | =
+ | V

V

Z

BE T
R R

R
Þ
= | = 149Ω
7,7

0,5
R4 | R3

Se alege R4 = 150Ω, ±5%

### 2.9 PROTECŢIA LA SCURTCIRCUIT

Protecţia la scurtcircuit a amplificatorului audio de putere se realizează prin şuntarea bazei tranzistoarelor T5 şi T6. Pentru semialternanţa pozitivă la supracurent detectat prin creşterea tensiunii pe rezistenţa R28 tranzistorul T9 care este normal blocat se deschide şi va reduce semnalul aplicat pe baza lui T5. Sesizarea supracurentului şi polarizarea lui T5 se face prin doua circuite distincte:
- Un circuit cu acţiune rapidă care limitează vârfurile instantanee de curent
- Al doilea circuit cu acţiune întârziată care limitează curentul în cazul unui scurtcircuit de durată
1. Dimensionarea circuitului de protecţie la scurtcircuit cu acţiune rapidă

Pentru semialternanţa pozitivă tensiunea de pe R28 este transmisă prin divizorul R18-R19 şi dioda D6 pe baza tranzistorului T9. Se alege o valoare limită a curentului la care protecţia la scurtcircuit cu acţiune rapidă să intre în funcţiune, ISM = 7A. La această valoare a curentului tensiunea pe rezistenţa R28 are valoarea:

VR28 = I SM

- R28 = 2,73V

Amplificator audio de putere | 43

Tensiunea de deschidere a lui T9 ≅0,7V iar VD=0,6V. În acest caz, raportul de divizare este:

0,48
2,73

1,3

19 | 18

19
= =
R + R

R
Þ
18 | 19 | 08 | 19 1,
0,48
0,52 R = | R = | · R

Pentru a avea pe divizor un curent mic, se impune condiţia ca
R18 | R19 | 500 R28 + | ≥ | ·

Se alege R19 = 100Ω, ±5% şi rezultă R18 = 100Ω, ±5%.
În acest caz R18 + R19 = 200Ω = 513 R28; se verifica condiţia de a avea un curent mic pe divizorul R18-R19.

mA V
| R | | R

V
I
d | 13,65
200

2,73

18 | 19

28
=
Ω

=
+

=
; se verifică de asemenea şi condiţia

de stabilitate a PSF-ului tranzistorului T9:
d | B,T 9

I >> I

2. Dimensionarea circuitului de protecţie la scurtcircuit cu acţiune întârziată

Circuitul este o punte formată din: R28, RS, R24, T11 conectat ca diodă, D8 şi R22.

T9

R22

0

R24

Rs

R28

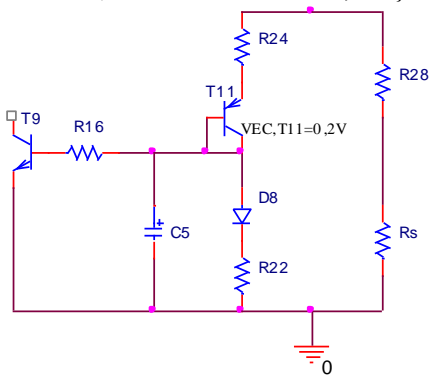
[picture p28: figure]
VEC,T11=0 ,2V

Figura 2.9-1. Puntea | Figura 2.9-2. Puntea
R28, RS - R24, R22 | R28, RS - R24, T11, D8, R22

Alimentarea punţii pe o diagonală se face cu tensiunea de pe R28 şi RS. In diagonala cealaltă este conectată joncţiunea baza-emitor a tranzistorului T9. Divizorul R24-R22 polarizează tranzistorul T9 astfel încât să fie blocat când amplificatorul lucrează normal pe RS = 4Ω. Când RS < 4Ω şi scade, puntea se dezechilibrează crescând căderea de tensiune pe R28 şi T9 începe să conducă limitând semnalul de pe baza lui T5. La scurtcircuit (RS = 0Ω) întreaga cădere de tensiune de pe R28 se transmite pe baza lui T9. La un curent de 2A se obţine V28 = 0,8V. Se dimensionează pentru această tensiune divizorul R24-R22. În caz de scurtcircuit curentul va fi limitat la aproximativ 2A.
Căderile de tensiune pe T11 şi D8 sunt aproximativ egale cu 0,2V respectiv 0,6V iar tensiunea de deschidere a tranzistorului T9 ≅ 0,7V

44 | Proiectarea circuitelor electronice de audiofrecvenţă
În acest caz avem VD8+VR22 = VBE,T9 | şi atunci Þ VR22 = 0,1V.
Se alege R24 = 0,1R22 astfel încât pentru scurtcircuit (RS = 0Ω) pe R28 va fi necesară pentru deschiderea tranzistorului T9 o tensiune:

VR28neces = 0,1V + 0,6V + 0,2V + 0,01V = 0,91V.
Se apreciază că circuitul va limita curentul la:

A

V
R
VR | neces | 2,3
0,39

0,91

28

28
=
Ω

=

Se alege dioda D8 din siliciu de comutaţie de tipul 1N4148, având următorii parametri:
Valori limită absolute: VR = 75V | IF = 200mA
Tj = 200°C | VF = 1V, la IF = 10mA
Caracteristici electrice: IR = 25nA | VR = 20V
Ctot = 4pF | trr = 4ns
Se alege constanta de timp, respectiv întârzierea până la acţionarea protecţiei τ = 80ms corespunzătoare unei frecvenţe de 2Hz. Se alege o valoare acceptabilă pentru C5 de 200µF. În acest caz avem:

≈ = 400Ω

5

24 C

R

τ

Se alege R24 = 390Ω, ±5% şi rezultă valoarea rezistenţei R22 =3,9kΩ, ±5%.

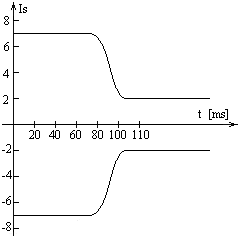
[picture p29: figure]

Figura 2.9-3. Estimarea răspunsului limitatorului de curent la scurtcircuit

3. Protecţia la suprasarcină

Prin aplicarea unei tensiuni de intrare mai mari ca Vg = 1,5V se poate ajunge la suprasarcini şi distorsionarea semnalului de ieşire prin limitarea amplitudinii la valoarea tensiunii sursei de alimentare respectiv 27V.
Pentru evitarea acestor suprasarcini de scurtă sau lungă durată între baza tranzistorului pilot şi masă, se montează două diode D2, D3 înseriate.

Amplificator audio de putere | 45

Diodele se aleg din siliciu de comutaţie de tipul 1N4148, având următorii parametri:
Valori limită absolute: VR = 75V | IF = 200mA
Tj = 200°C | VF = 1V, la IF = 10mA
Caracteristici electrice: IR = 25nA | VR = 20V
Ctot = 4pF | trr = 4ns
Prin aceasta tensiunea maximă ce poate apare pe baza pilotului în raport cu masa este: Vpilot,max = 2 · 0,6V = 1,2V
Curentul maxim prin tranzistorul pilot la care acţionează protecţia la suprasarcină este:

Isupras =
27Ω

0,6V
= 22mA >> 8mA

Tensiunea maximă pe finali la care acţionează protecţia la suprasarcină este: Vsupras = Isupras · Rdin,pilot = 22mA · 3,6KΩ = 79V >> 27V

### 2.10 SIMULAREA AMPLIFICATORULUI ŞI OPTIMIZAREA

ETAJELOR CU PSPICE

Simularea amplificatorului audio de putere

Simularea amplificatorului audio de putere a fost efectuată la început din punct de vedere al punctului static de funcţionare. Deoarece nu se utilizează condensator la ieşirea pe difuzor este necesară obţinerea unei tensiuni la ieşirea pe difuzor cât mai apropiată de 0V prin ajustarea rezistenţei semireglabile R9 care în simulare a fost înlocuită cu două rezistenţe obişnuite respectiv R9 şi R91. pentru R9 = 250Ω şi R91 = 260Ω la ieşirea pe difuzor se obţine o componentă continuă de 72,33nV valoare care este suficient de mică.
Comparând PSFurile tranzistoarelor simulate cu cele proiectate se observă abateri destul de mici:
ICT1 = 241,6µA, ICT2 = 255,2µA faţă de ICT1 = ICT2 = 250µA
IBZ-081 = 5,044mA faţă de IZ = 5mA
ICT3 = 7,734mA faţă de ICT3 = 8mA
ICT7 = ICT8 = 2,467mA, valoare acceptabilă pentru eliminarea distorsiunilor de trecere, obţinută prin reglarea rezistenţei semireglabile R14 = 2,5KΩ, care în simulare a fost înlocuită cu două rezistenţe fixe R141 = 1,3KΩ şi R142 = 1,2KΩ. După simularea PSFului s-a efectuat o simulare tranzitorie şi au fost extrase semnalele din punctele indicate în Figura 2.10-2. iar aceste semnale pot fi vizualizate în Figura 2.10-3. respectiv semnalul de la generatorul de semnal cu amplitudinea de 1V, până la ieşire, respectiv semnalul pe Rs din Figura 2.10-7., cu amplitudinea de 10V. Se deduce uşor că amplificarea în tensiune are valoarea 10, valoare ce corespunde cu cea din tema de proiectare.

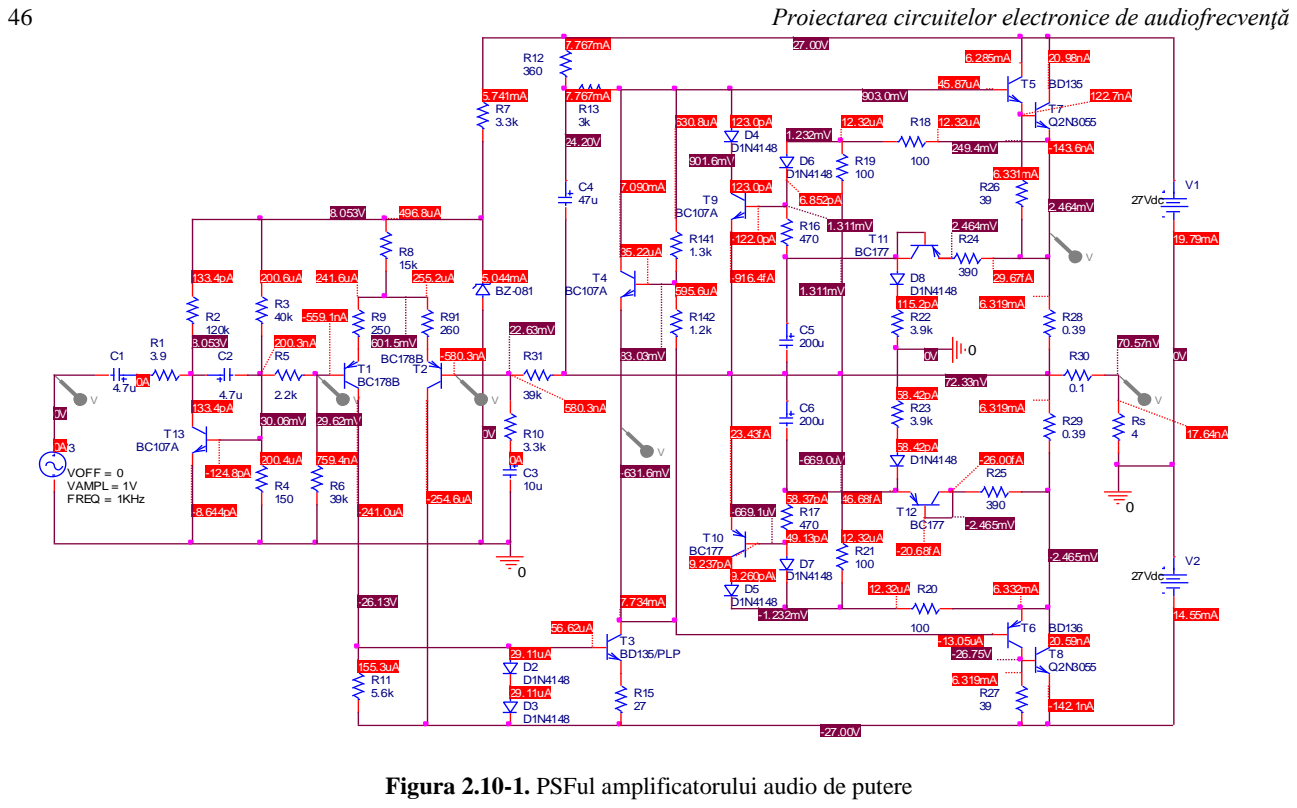
[picture p30: page 24]

Figura 2.10-1. PSFul amplificatorului audio de putere

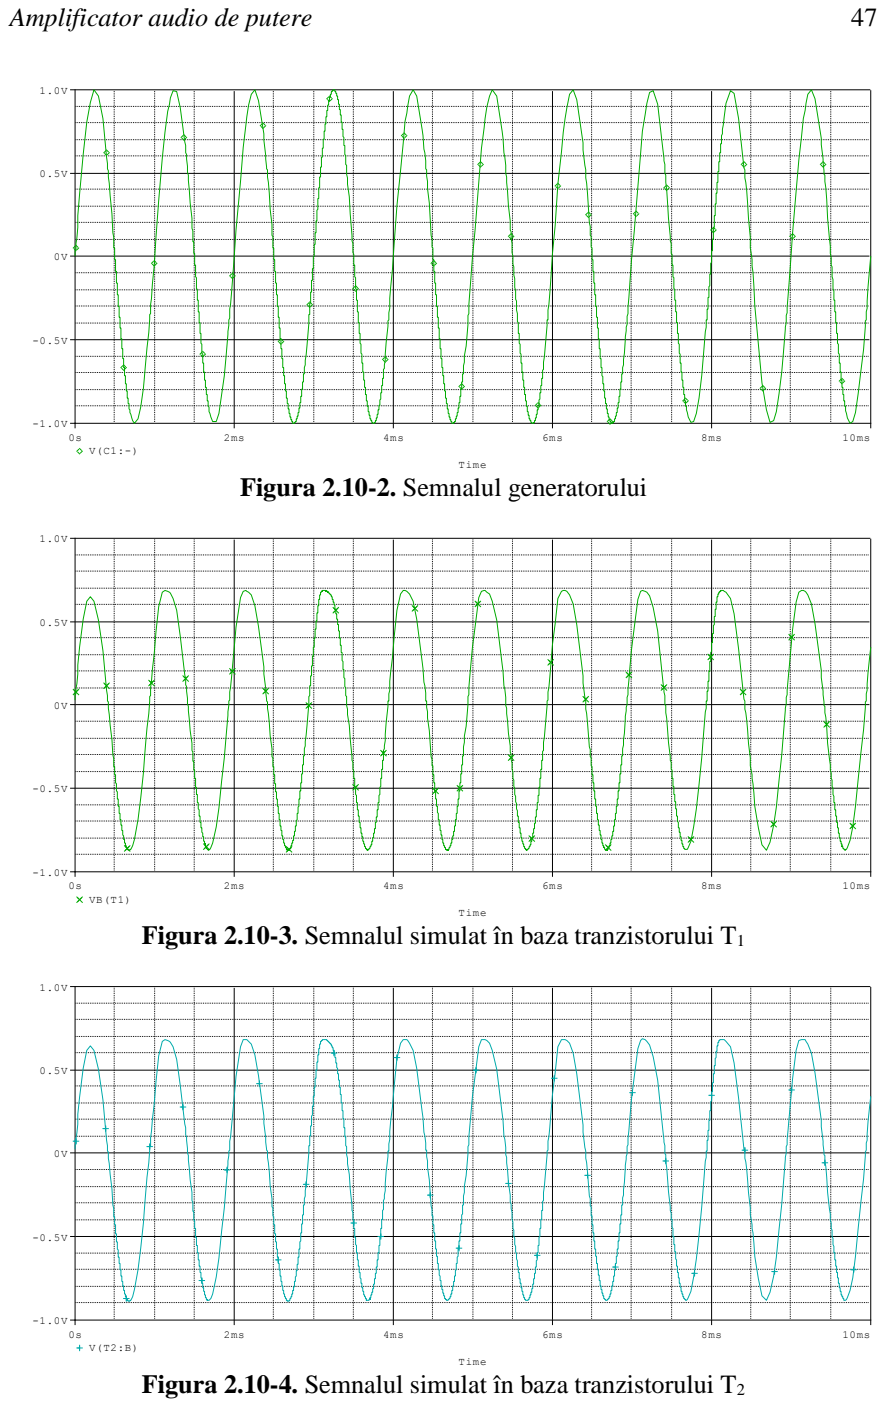
[picture p31: page 25]
Amplificator audio de putere; Time

Figura 2.10-2. Semnalul generatorului

Figura 2.10-3. Semnalul simulat în baza tranzistorului T1

Figura 2.10-4. Semnalul simulat în baza tranzistorului T2

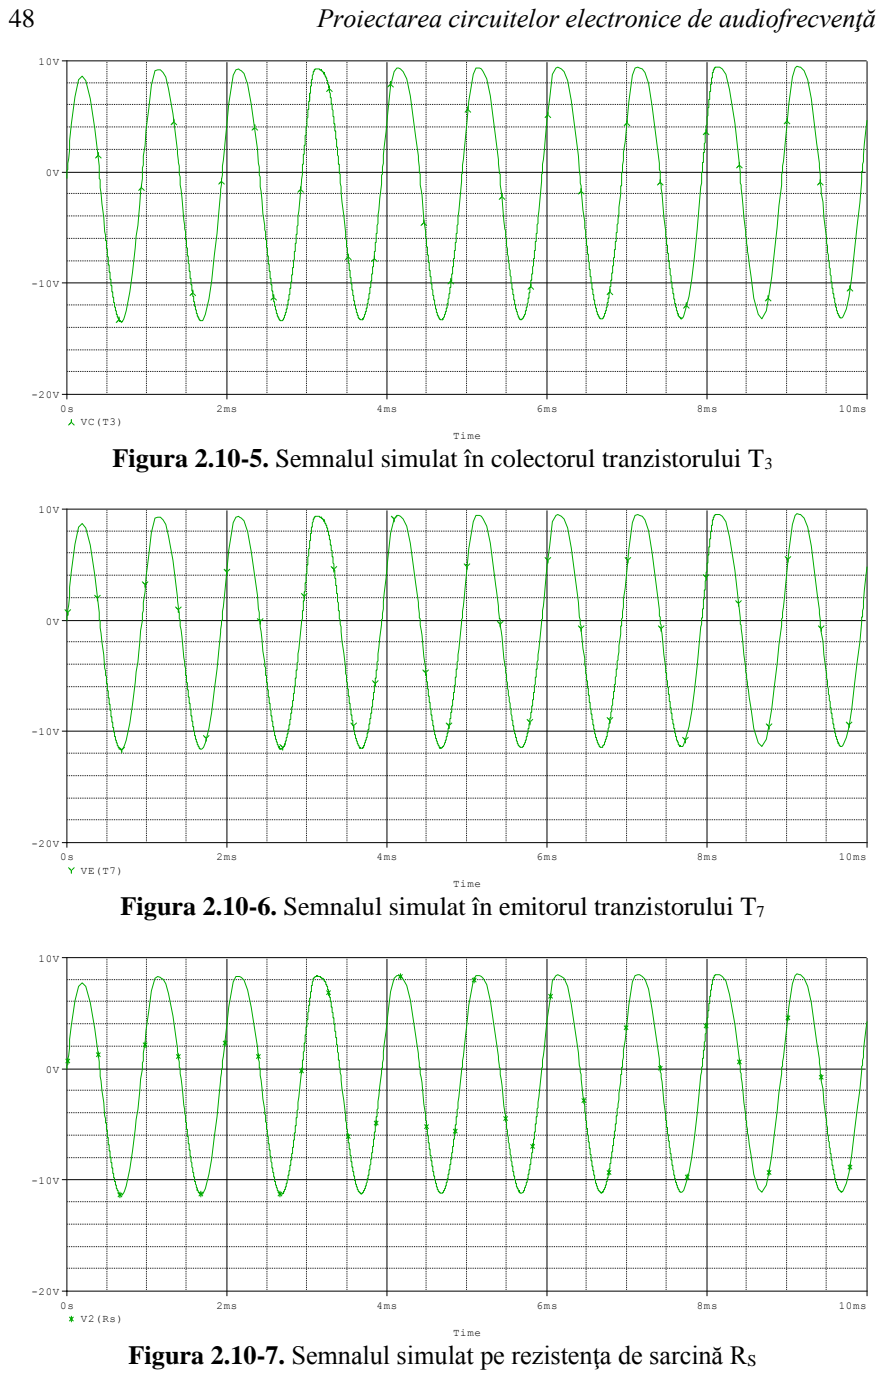
[picture p32: page 26]
Proiectarea circuitelor electronice de audiofrecvenţă; Time

Figura 2.10-5. Semnalul simulat în colectorul tranzistorului T3

Figura 2.10-6. Semnalul simulat în emitorul tranzistorului T7

Figura 2.10-7. Semnalul simulat pe rezistenţa de sarcină RS

Amplificator audio de putere | 49

Optimizarea etajului final

Pentru împerecherea celor două configuraţii darligton ale etajului final se utilizează circuitul din figura următoare în care se modifică valoarea rezistenţelor R1 şi R2 pentru obţinerea unor amplificări în curent uniforme şi de valori apropiate. În diagramele următoare este indicată variaţia amplificării IE(Q1)/IB(Q2) şi IE(Q3)/IB(Q4) la modificarea curentului furnizat de generatorul I1 în plaja 0÷10mA cu

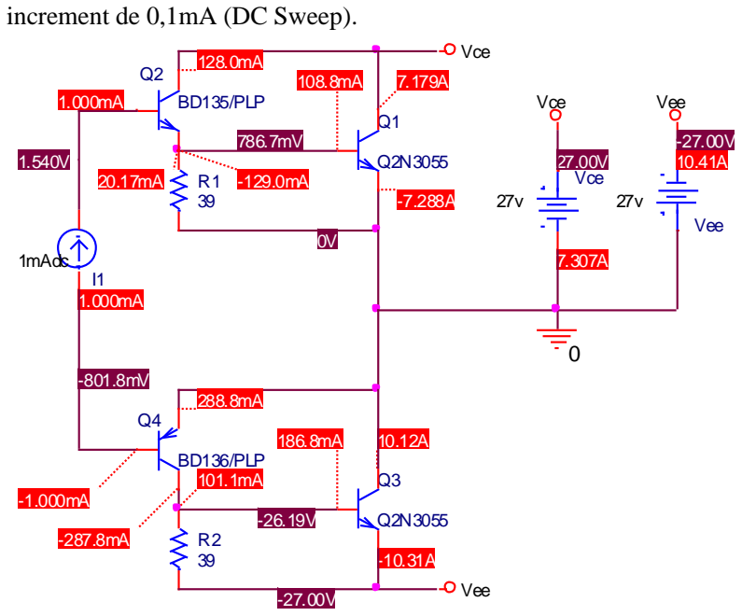
[picture p33: figure]
increment de 0,1mA (DC Sweep).; Vce; Vee; 1mAdc; BD135/PLP; BD136/PLP

Figura 2.10-8. PSFul etajului final polarizat prin generatorul I1 la 1mA

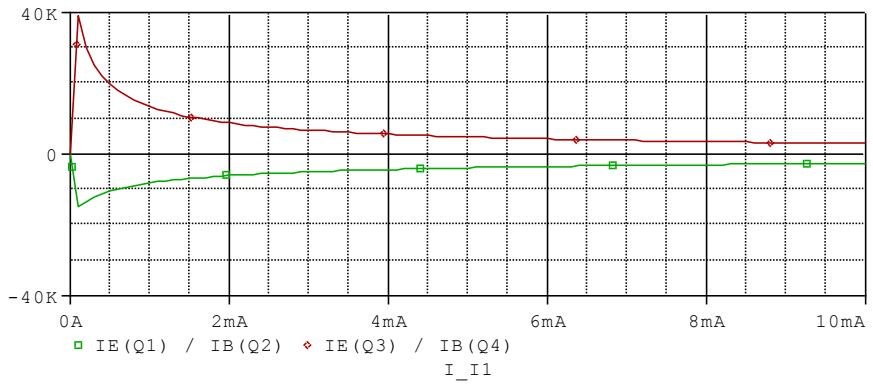
[picture p34: figure]

Figura 2.10-9. Simularea câştigului static în curent pentru darlingtonul npn IE(Q1)/IB(Q2) şi darlingtonul pnp IE(Q3)/IB(Q4), la R1=R2=20KΩ

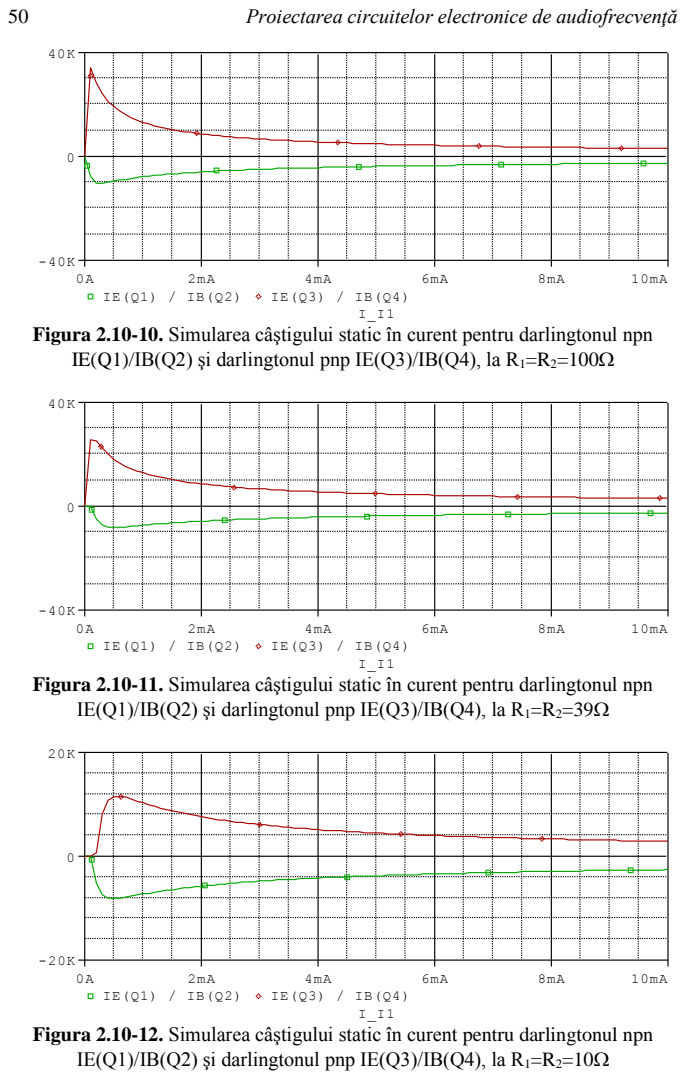
[picture p35: page 28]
Proiectarea circuitelor electronice de audiofrecvenţă

Figura 2.10-10. Simularea câştigului static în curent pentru darlingtonul npn
IE(Q1)/IB(Q2) şi darlingtonul pnp IE(Q3)/IB(Q4), la R1=R2=100Ω

Figura 2.10-11. Simularea câştigului static în curent pentru darlingtonul npn
IE(Q1)/IB(Q2) şi darlingtonul pnp IE(Q3)/IB(Q4), la R1=R2=39Ω

Figura 2.10-12. Simularea câştigului static în curent pentru darlingtonul npn
IE(Q1)/IB(Q2) şi darlingtonul pnp IE(Q3)/IB(Q4), la R1=R2=10Ω

Amplificator audio de putere | 51

Se observă că pentru R1=R2=39Ω se obţine un bun compromis între câştigul static în curent şi liniaritatea caracteristicilor.

Optimizarea etajului pilot

Pentru exemplificarea optimizării etajului pilot utilizăm schema următoare care are avantajul de a fi mai simplă.

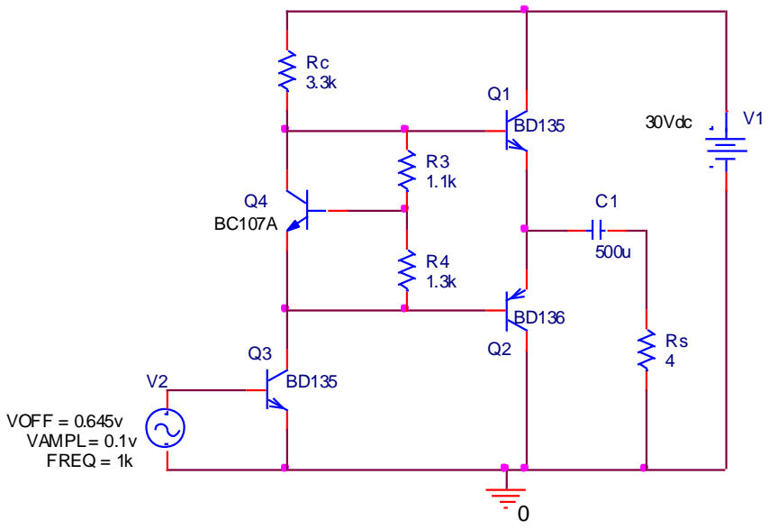
[picture p36: figure]
30Vdc; FREQ = 1k; VAMPL = 0.1v; VOFF = 0.645v

Figura 2.10-13. Configuraţia clasică a etajului pilot

Pentru stabilirea corectă a PSFului tranzistorului pilot se face o simulare cu baleiaj în curent continuu (DC Sweep) în care variabila este sursa V2 prin componenta VOFF în domeniul 0,2V÷0,7V cu increment 0,1V.

V_V2

200mV | 300mV | 400mV | 500mV | 600mV | 700mV
IC(Q3)

0A

5mA

10mA

Figura 2.10-14. Simularea curentului prin tranzistorul pilot în funcţie de VOFF

52 | Proiectarea circuitelor electronice de audiofrecvenţă

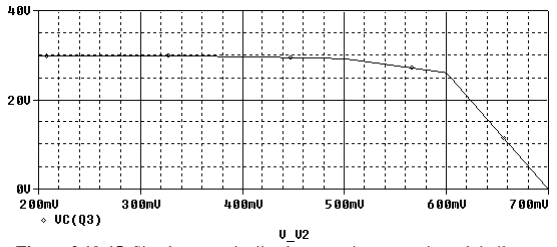
[picture p37: figure]

Figura 2.10-15. Simularea tensiunii colector-emitor a tranzistorului pilot
în funcţie de VOFF

Se alege polarizarea tranzistorului pilot la VCE =14,31V şi IC,T3, = 4,4mA corespunzătoare unei tensiuni de ieşire de ≅15V. Polarizarea pilotului în acest PSF se face cu ajutorul tensiunii de polarizare a bazei VOFF = 0,645V.
Polarizarea tranzistorilor finali se face din raportul rezistenţelor R3, R4. Pentru R3 = 1,1KΩ şi R4 =1,3KΩ se obţine un curent de repaus prin finali de ≅ 9mA.

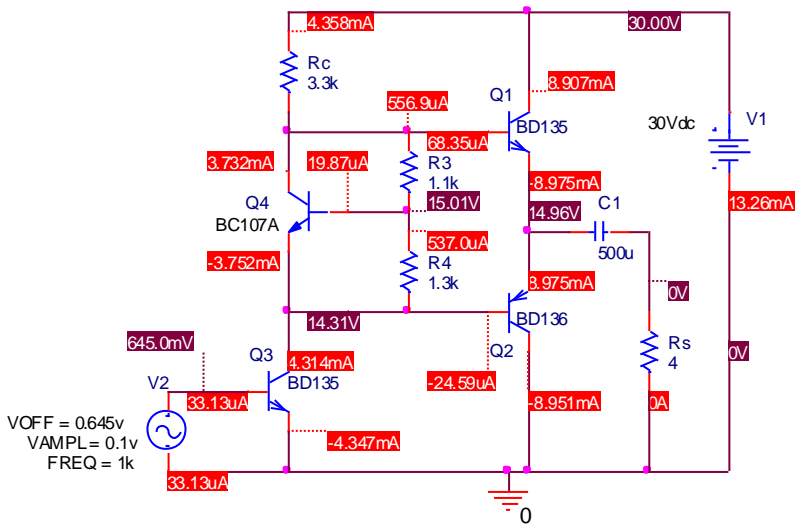
[picture p38: figure]
30Vdc; FREQ = 1k; VAMPL = 0.1v; VOFF = 0.645v

Figura 2.10-16. Simularea PSFului etajului pilot şi final la VOFF=0,645V

Pentru compararea efectului conexiunii bootstrap se atacă ambele etaje cu şi fără conexiune bootstrap de la aceeaşi sursă de semnal V2.

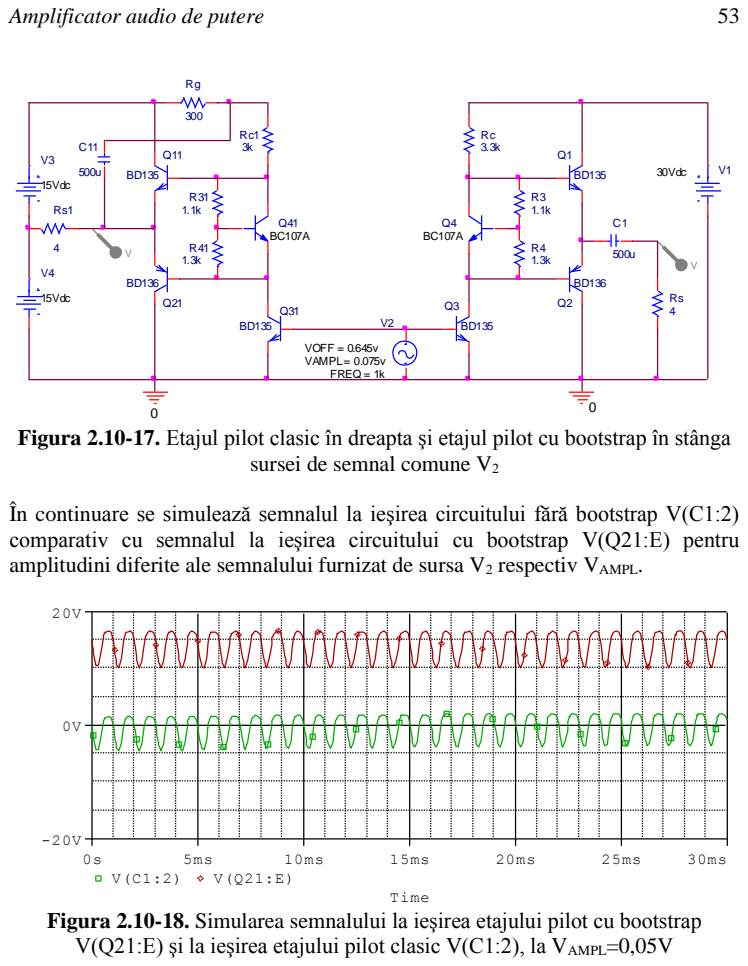
[picture p39: page 31]

Figura 2.10-17. Etajul pilot clasic în dreapta şi etajul pilot cu bootstrap în stânga

sursei de semnal comune V2

În continuare se simulează semnalul la ieşirea circuitului fără bootstrap V(C1:2)
comparativ cu semnalul la ieşirea circuitului cu bootstrap V(Q21:E) pentru
amplitudini diferite ale semnalului furnizat de sursa V2 respectiv VAMPL.

Figura 2.10-18. Simularea semnalului la ieşirea etajului pilot cu bootstrap
V(Q21:E) şi la ieşirea etajului pilot clasic V(C1:2), la VAMPL=0,05V

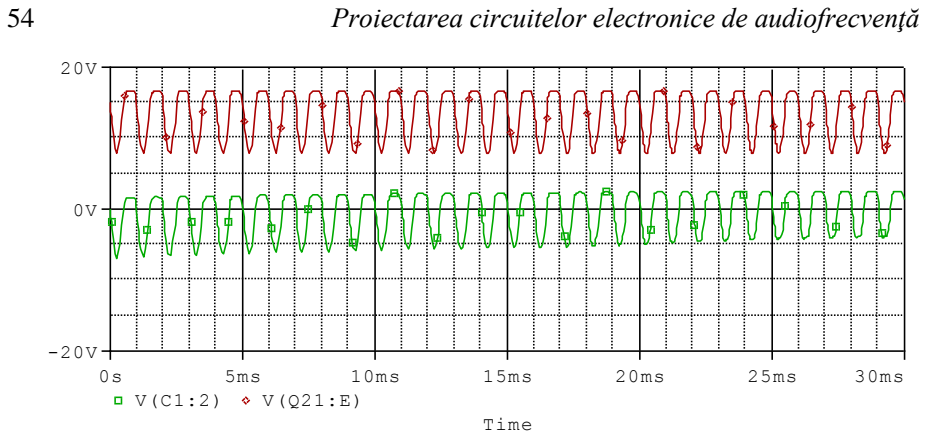
[picture p40: figure]
Proiectarea circuitelor electronice de audiofrecvenţă; Time

Figura 2.10-19. Simularea semnalului la ieşirea etajului pilot cu bootstrap V(Q21:E) şi la ieşirea etajului pilot clasic V(C1:2), la VAMPL=0,075V

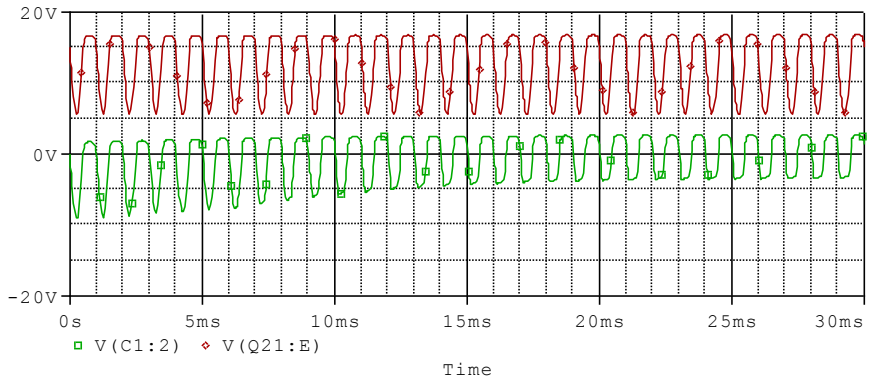
[picture p41: figure]
Time

Figura 2.10-20. Simularea semnalului la ieşirea etajului pilot cu bootstrap V(Q21:E) şi la ieşirea etajului pilot clasic V(C1:2), la VAMPL=0,1V

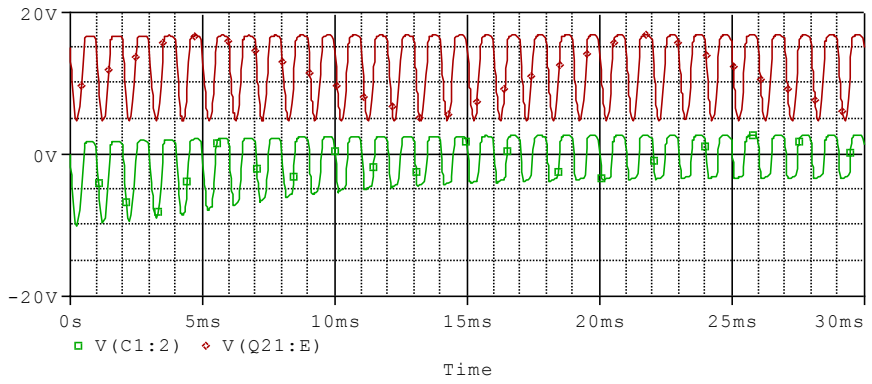
[picture p42: figure]
Time

Figura 2.10-21. Simularea semnalului la ieşirea etajului pilot cu bootstrap V(Q21:E) şi la ieşirea etajului pilot clasic V(C1:2), la VAMPL=0,11V

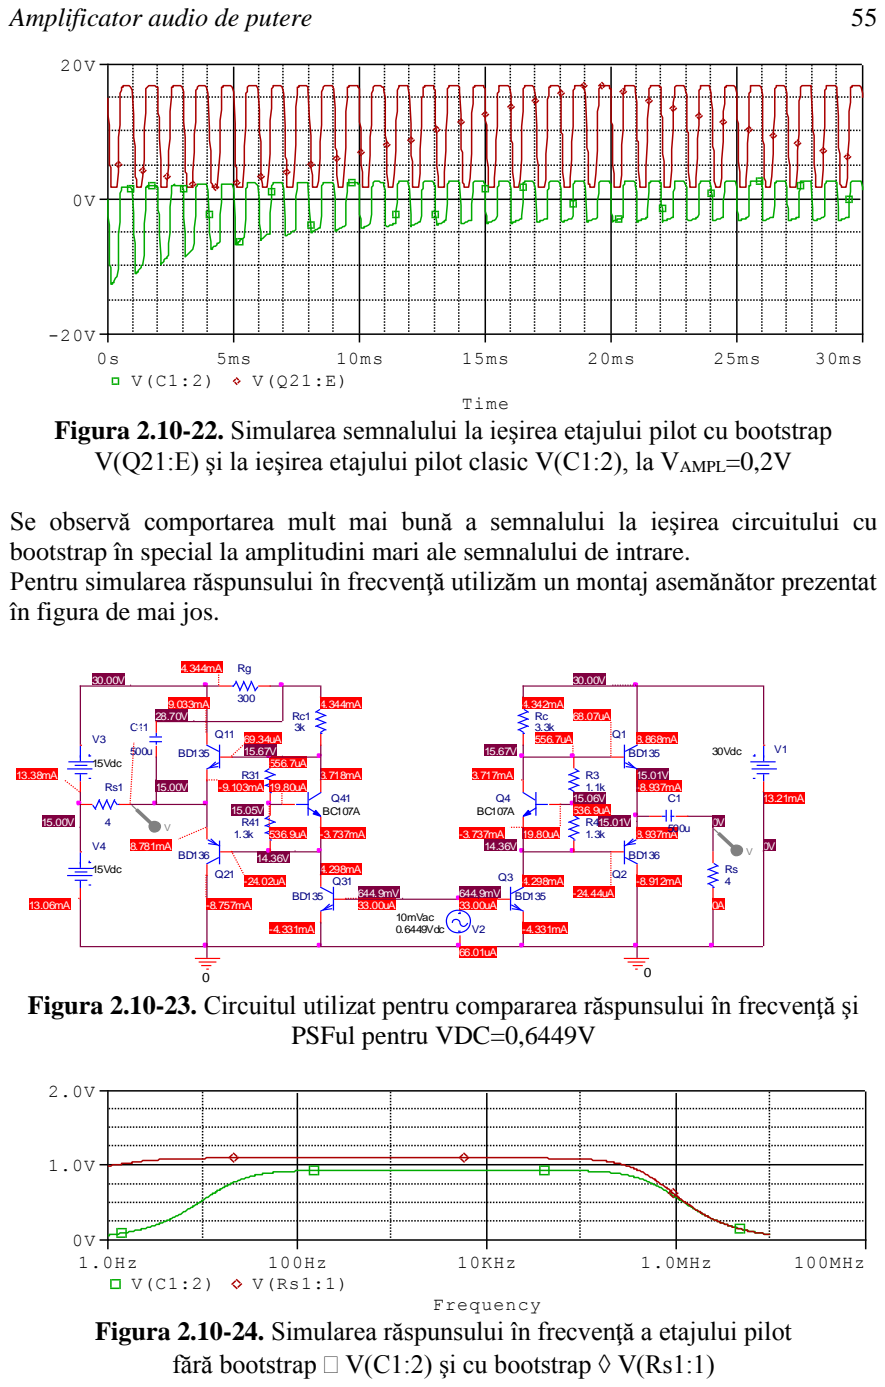
[picture p43: page 33]

Figura 2.10-22. Simularea semnalului la ieşirea etajului pilot cu bootstrap
V(Q21:E) şi la ieşirea etajului pilot clasic V(C1:2), la VAMPL=0,2V

Se observă comportarea mult mai bună a semnalului la ieşirea circuitului cu
bootstrap în special la amplitudini mari ale semnalului de intrare.
Pentru simularea răspunsului în frecvenţă utilizăm un montaj asemănător prezentat
în figura de mai jos.

Figura 2.10-23. Circuitul utilizat pentru compararea răspunsului în frecvenţă şi

Figura 2.10-24. Simularea răspunsului în frecvenţă a etajului pilot

fără bootstrap V(C1:2) şi cu bootstrap ◊ V(Rs1:1)

56 | Proiectarea circuitelor electronice de audiofrecvenţă

Este evident că şi din punctul de vedere al răspunsului în frecvenţă circuitul cu bootstrap se comportă mai bine.

Optimizarea etajului diferenţial

Optimizarea etajului diferenţial se poate face din punct de vedere static şi anume al obţinerii unei tensiunii pe sarcină la o valoare cât mai aproape de zero. În acest scop în toate simulările rezistenţa variabilă R9 a fost realizată din R9=250Ω şi R91=260Ω valori pentru care se obţine în repaus o tensiune de 70,57nV (Figura 2.10-1.) valoare suficient de apropiată de 0V.
O altă optimizare a etajului diferenţial se poate face din punct de vedere al tipului de amplificator, respectiv neinversor sau inversor, fapt care este stabilit din modul de configurare a reacţiei negative conform cu Figura 2.10-26..

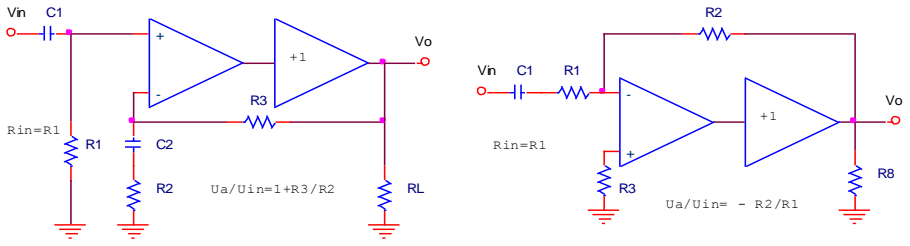
[picture p44: figure]
Vin; Rin=R1; Ua/Uin=1+R3/R2; Ua/Uin= - R2/R1

Figura 2.10-25. Amplificator audio de putere neinversor (stânga) şi amplificator audio de putere inversor (dreapta)

La prima vedere comportarea celor două tipuri de amplificatoare pare identică, iar din punct de vedere al reproducerii fazei semnalului suntem tentaţi să alegem configuraţia neinversor.
Diferenţa cea mai importantă dintre cele două tipuri de amplificatoare este dată de răspunsul în frecvenţă care este mai bun la amplificatorul inversor. Explicaţia constă în modul de realizare a reacţiei negative.
La amplificatorul inversor reacţia se face prin R1 şi nodul de tensiune 2 iar la amplificatorul neinversor se face prin R1 şi etajul diferenţial plasat între nodurile 2 şi 3. Deoarece răspunsul în frecvenţă al etajului diferenţial este limitat pe când răspunsul în frecvenţă al nodului de tensiune este infinit rezultă comportarea mai bună în frecvenţă a etajului inversor comparativ cu cel neinversor. Pentru a verifica funcţionarea acestui principiu configurăm amplificatorul audio de putere de tipul inversor ca în Figura 2.10-27. şi refacem simulările PSFului tranzitorii şi comparativ a răspunsului în frecvenţă.

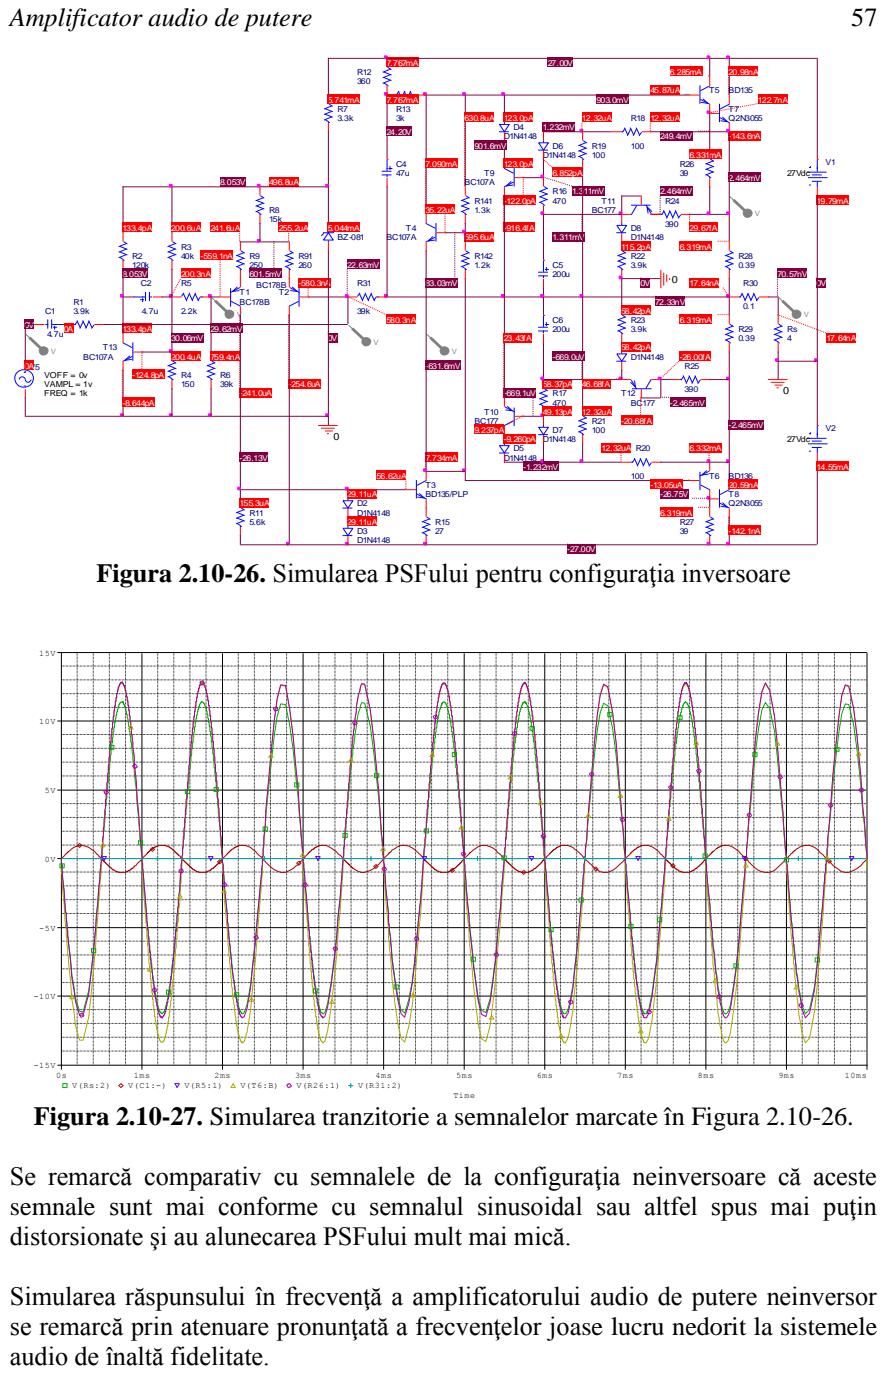
[picture p45: page 35]

Figura 2.10-26. Simularea PSFului pentru configuraţia inversoare

Figura 2.10-27. Simularea tranzitorie a semnalelor marcate în Figura 2.10-26.

Se remarcă comparativ cu semnalele de la configuraţia neinversoare că aceste
semnale sunt mai conforme cu semnalul sinusoidal sau altfel spus mai puţin
distorsionate şi au alunecarea PSFului mult mai mică.

Simularea răspunsului în frecvenţă a amplificatorului audio de putere neinversor
se remarcă prin atenuare pronunţată a frecvenţelor joase lucru nedorit la sistemele
audio de înaltă fidelitate.

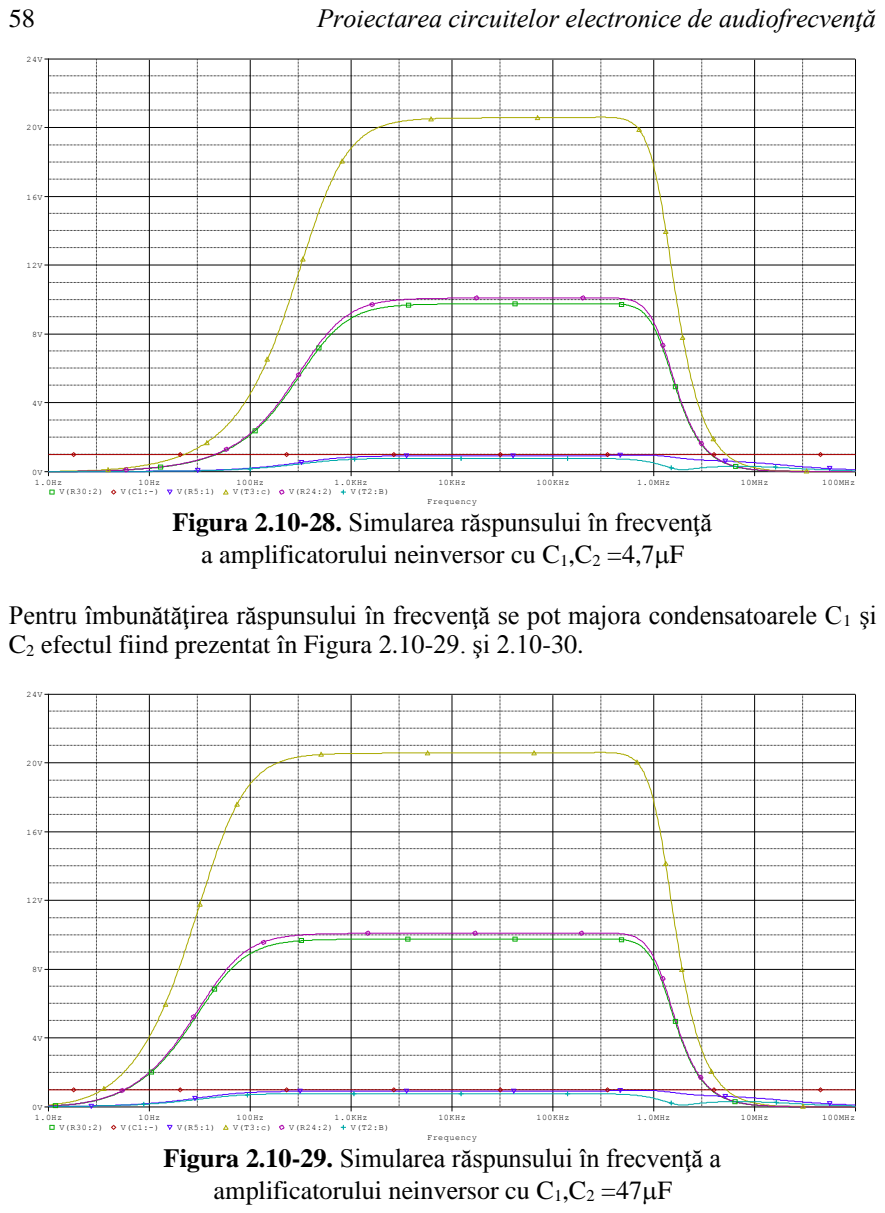
[picture p46: page 36]
Proiectarea circuitelor electronice de audiofrecvenţă; Frequency; 1.0KHz; 10KHz; 100KHz; 1.0MHz; 10MHz; 100MHz

Figura 2.10-28. Simularea răspunsului în frecvenţă
a amplificatorului neinversor cu C1,C2 =4,7µF

Pentru îmbunătăţirea răspunsului în frecvenţă se pot majora condensatoarele C1 şi
C2 efectul fiind prezentat în Figura 2.10-29. şi 2.10-30.

Figura 2.10-29. Simularea răspunsului în frecvenţă a
amplificatorului neinversor cu C1,C2 =47µF

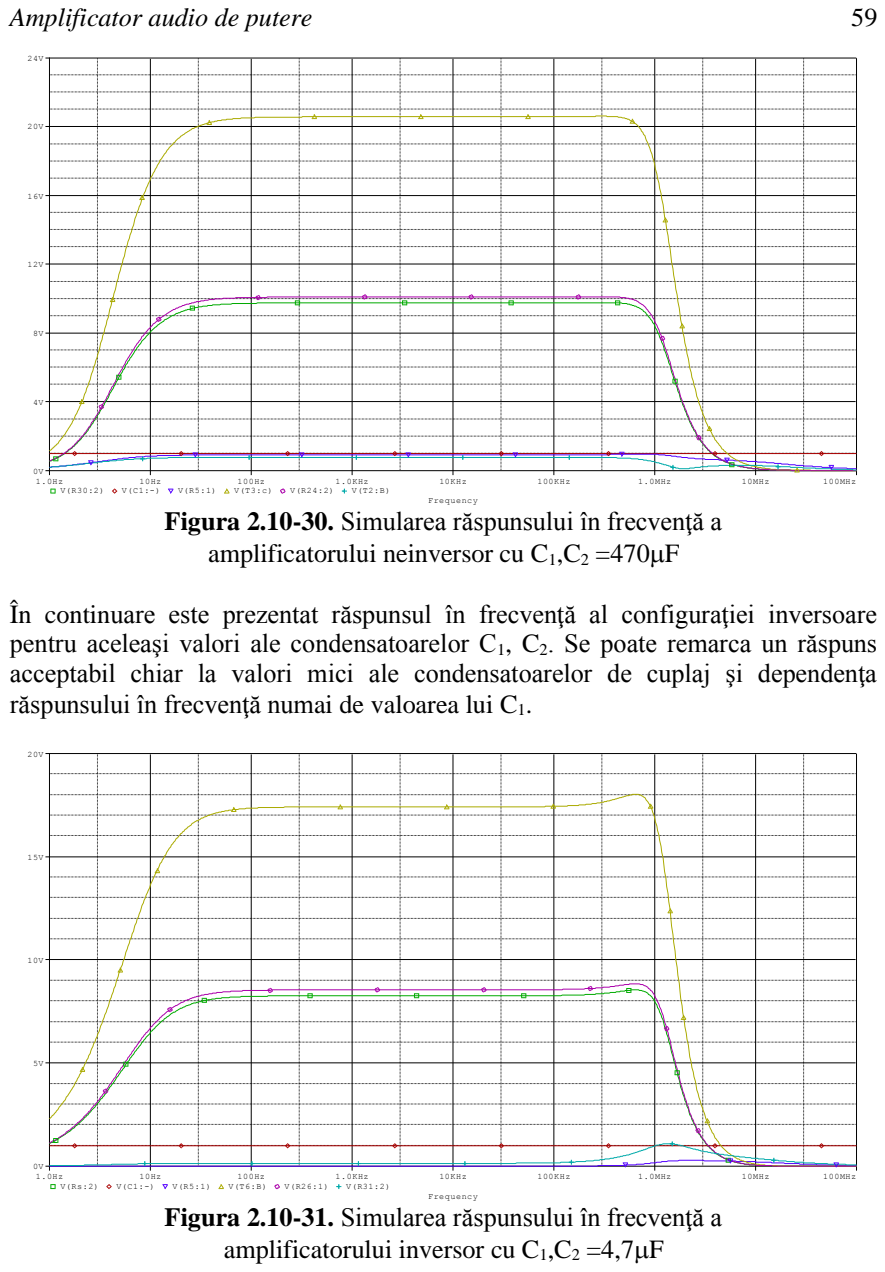
[picture p47: page 37]
Amplificator audio de putere; Frequency; 1.0KHz; 10KHz; 100KHz; 1.0MHz; 10MHz; 100MHz

Figura 2.10-30. Simularea răspunsului în frecvenţă a
amplificatorului neinversor cu C1,C2 =470µF

În continuare este prezentat răspunsul în frecvenţă al configuraţiei inversoare
pentru aceleaşi valori ale condensatoarelor C1, C2. Se poate remarca un răspuns
acceptabil chiar la valori mici ale condensatoarelor de cuplaj şi dependenţa
răspunsului în frecvenţă numai de valoarea lui C1.

Figura 2.10-31. Simularea răspunsului în frecvenţă a
amplificatorului inversor cu C1,C2 =4,7µF

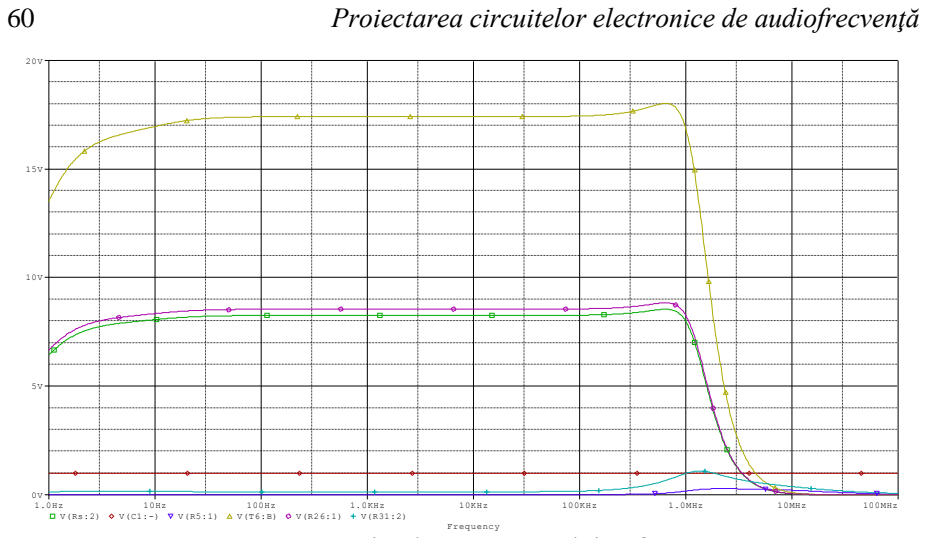
[picture p48: figure]
Proiectarea circuitelor electronice de audiofrecvenţă; Frequency; 1.0KHz; 10KHz; 100KHz; 1.0MHz; 10MHz; 100MHz

Figura 2.10-32. Simularea răspunsului în frecvenţă a

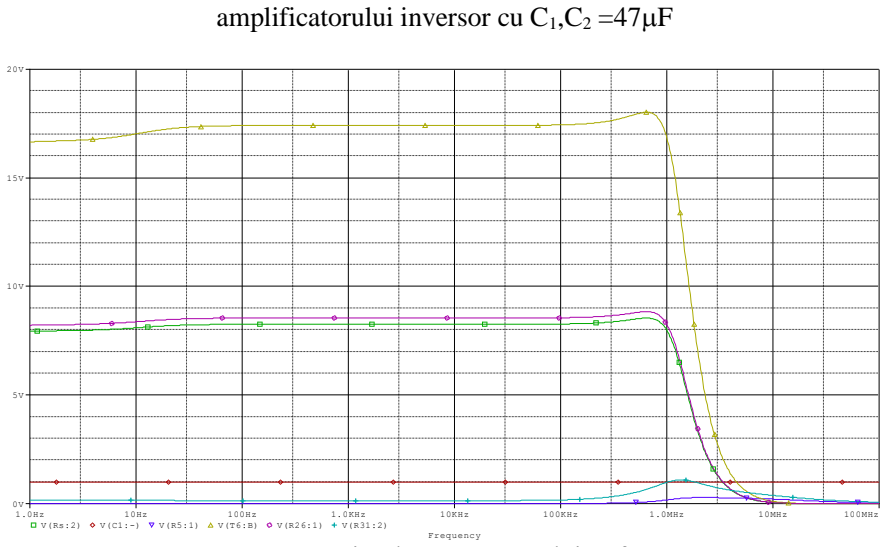
[picture p49: figure]
amplificatorului inversor cu C1,C2 =47µF; Frequency; 1.0KHz; 10KHz; 100KHz; 1.0MHz; 10MHz; 100MHz

Figura 2.10-33. Simularea răspunsului în frecvenţă a amplificatorului inversor cu C1,C2 =470µF

Simularea la scurtcircuit

Pentru simularea la scurtcircuit se foloseşte schema electronică completă în care se micşorează valoarea rezistenţei de sarcină Rs.
Micşorând rezistenţa de sarcină Rs se observă că nu apar modificări semnificative în forma semnalelor simulate până la Rs=1Ω şi din aceste considerente se fac simulări la trei valori ale rezistenţei de sarcină de 1Ω, 0,1Ω şi 0,01Ω.

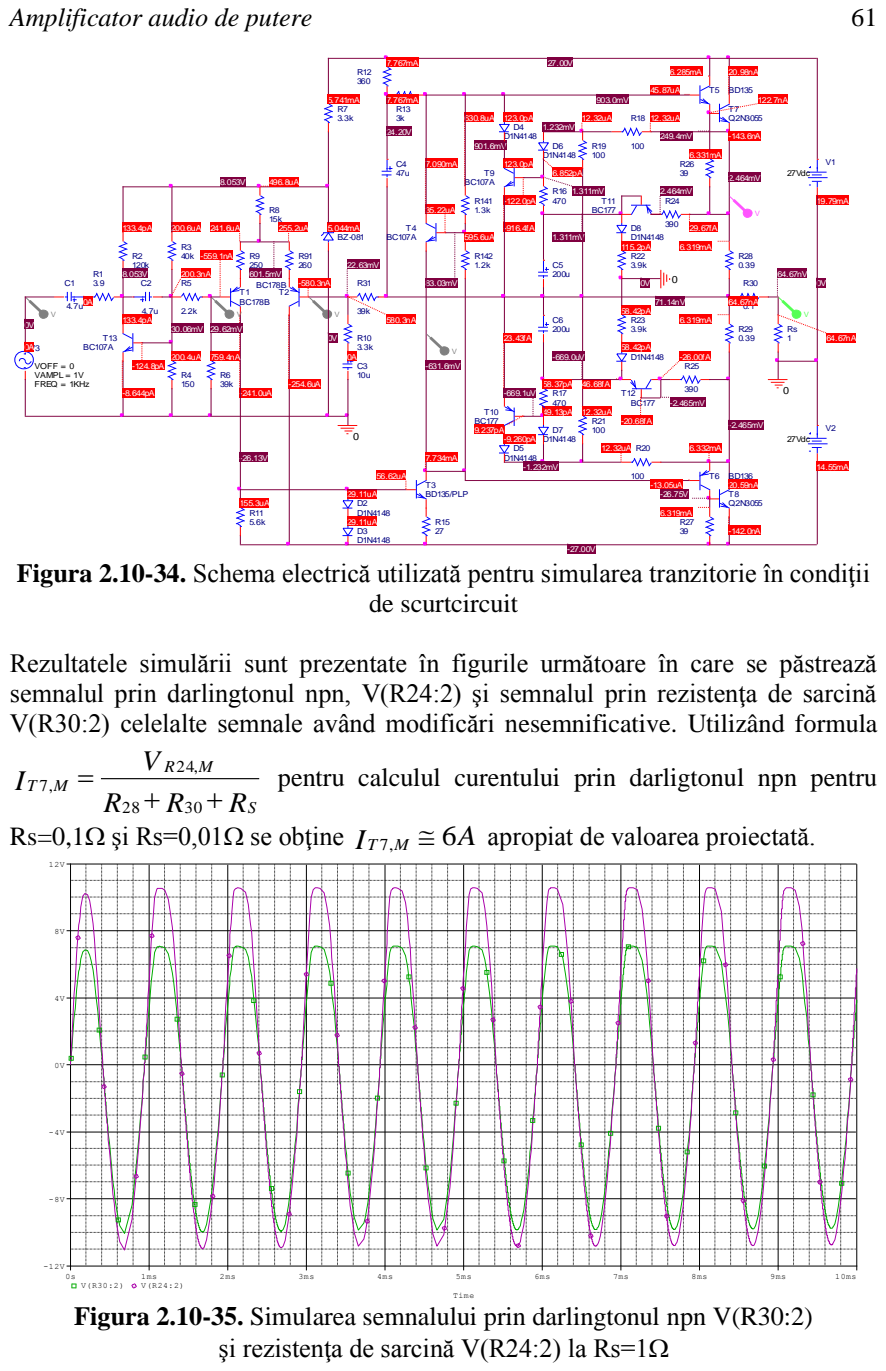
[picture p50: page 39]

Figura 2.10-34. Schema electrică utilizată pentru simularea tranzitorie în condiţii

Rezultatele simulării sunt prezentate în figurile următoare în care se păstrează
semnalul prin darlingtonul npn, V(R24:2) şi semnalul prin rezistenţa de sarcină
V(R30:2) celelalte semnale având modificări nesemnificative. Utilizând formula

Rs=0,1Ω şi Rs=0,01Ω se obţine

apropiat de valoarea proiectată.

Figura 2.10-35. Simularea semnalului prin darlingtonul npn V(R30:2)

şi rezistenţa de sarcină V(R24:2) la Rs=1Ω

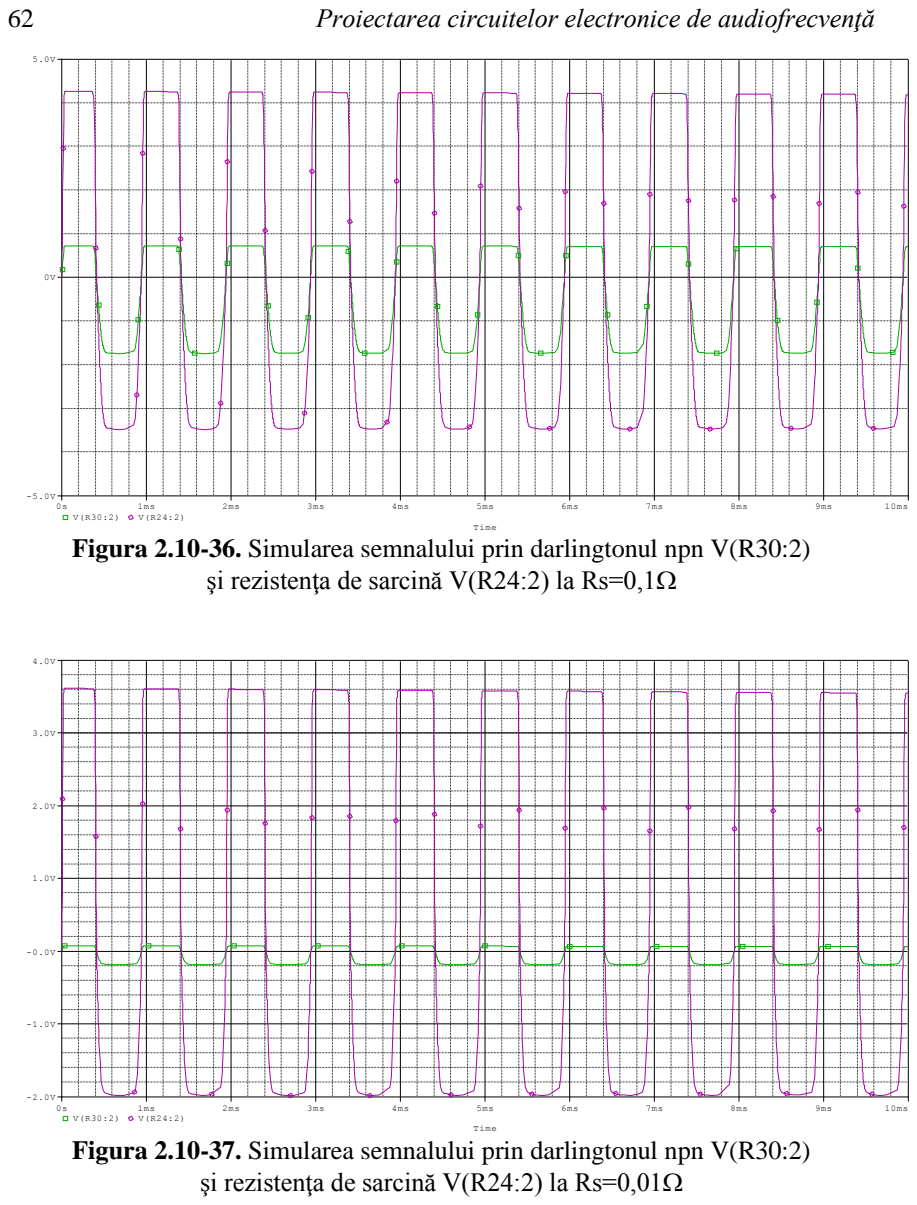
[picture p51: page 40]
Proiectarea circuitelor electronice de audiofrecvenţă; Time

Figura 2.10-36. Simularea semnalului prin darlingtonul npn V(R30:2)

şi rezistenţa de sarcină V(R24:2) la Rs=0,1Ω

Figura 2.10-37. Simularea semnalului prin darlingtonul npn V(R30:2)

şi rezistenţa de sarcină V(R24:2) la Rs=0,01Ω

Amplificator audio de putere | 63
2. 11 SURSA DE ALIMENTARE

Sursa de alimentare pentru etajul final este constituită dintr-un transformator coborâtor de tensiune care are înfăşurarea secundară cu priză mediană. Acest fapt permite ca după redresare şi filtrare să se obţină faţă de masă două tensiuni egale şi de semne opuse.
Această configuraţie are avantajul utilizării unei singure punţi redresoare pentru cele două tensiuni.

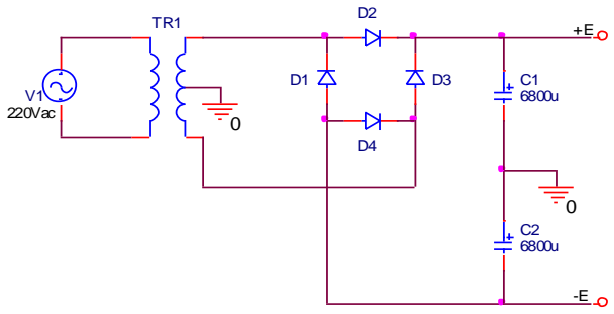
[picture p52: figure]
V1 220Vac

Figura 2.11-1. Sursa de alimentare a amplificatorului audio de putere

Dimensionarea redresorului

1. Dimensionarea condensatorilor de filtraj
Pentru dimensionarea capacităţilor de filtraj se estimează curentul mediu consumat de amplificator la 2A şi corespunzător acestuia rezistenţa echivalentă a sursei pe una din tensiuni este RSE=13

Ω .
Se impune ca frecvenţa corespunzătoare constantei de timp t = CRSE să fie mult mai mică decât frecvenţa de tăiere în bandă respectiv 10Hz.

Se alege f=2Hz
f R

C
SE · · ·

Þ =
2 π

1

1,2

= 6121µF

Se alege C1,2 = 6800µF

2. Dimensionarea punţii redresoare
Pentru dimensionarea punţii redresoare calculăm tensiunea inversă şi curentul maxim prin aceasta:
5 | max 1, Vinv | VR
= | ·
=1,5 · 2 · 27 = 81V
max | 5 max 3, R
I | = | I
= 3,5 · 1,41 · 2 = 9,9A

Se alege o punte 20PM1 cu tensiunea inversă de 100V şi curentul maxim de 30A.

64 | Proiectarea circuitelor electronice de audiofrecvenţă

Dimensionarea transformatorului

1. Datele de calcul ale transformatorului
Principalele date de calcul ale transformatorului sunt:
- Puterea aparentă secundară
Consumul estimat pe un canal este 88W iar pe patru canale 352W. Se ia 360W rotunjind cu puterea consumată de preamplificator şi celelalte etaje intermediare.
- Tensiunile în secundar
Pentru etajul final trebuie o tensiune continuă de 2x27Vcc adică
707 2 19Vef 2×27·0, | = × valoare eficace.
Pentru preamplificatoare trebuie 22,5Vef.
- Tensiunea în primar
Tensiunea în primar este V1 = 220Vef .
- Frecvenţa reţelei de alimentare Frecvenţa reţelei de alimentare este f = 50Hz
- Factorul de putere al sarcinii
Factorul de putere al sarcinii se consideră cosφ2 = 1.
2. Alegerea miezului
Se alege un miez din tole ştanţate E+I, din tablă de oţel electrotehnic, de grosime 0,5mm, având pierderi specifice în fier PFs = 2W/Kg
3. Intensităţile curenţilor transformatorului
Se consideră cosφ1=0,9 şi randamentul η = 0,9. Coeficientul k este egal cu 1 pentru transformatoare monofazate şi
| 3 pentru transformatoare trifazate.

I1 =
η φ

φ

1 | 1
2 | 2
cos

cos
- · ·

·
k V

S
=
1 220 0,9 0,9

360 1
- | · | ·

·
= 2A

I2f =
k V

S

2

2
·

=
1 38

360
·
= 9,5A, | I2p = 0,03A
4. Secţiunea miezului
Secţiunea miezului transformatorului se determină cu ajutorul relaţiei:

SM =
f B J

S k
k

M

G
S
- ·

1
unde:

kS este un coeficient care ţine cont de tipul transformatorului, de tipul bobinajului şi de numărul de faze al transformatorului. Conform tabelului următor kS=6,65.

Amplificator audio de putere | 65

Tabelul 2.11-1. Determinarea coeficientului kS
Numărul de faze | Tipul transformatorului | Tipul bobinajului | kS
1 | Cu coloane | Bobine circulare | 4,75
Bobine dreptunghiulare | 5,7
| În manta ( E + I ) | | 6,65
3 | Cu coloane | Bobine circulare | 3,5
Bobine dreptunghiulare | 4

S1 este puterea aparentă în primar S1 =
η

S2
=
0,9

360
= 400W

kG este raportul între greutăţile materialelor active fier respectiv cupru.
Depinde de gradul de solicitare al acestora şi anume inducţia magnetică în miez respectiv densitatea de curent în cupru. Uzual kG = 4÷7 pentru transformatoare calculate pentru preţ minim şi kG = 2÷3 pentru transformatoare calculate pentru greutate totală minimă. Alegem kG = 4.

Inducţia în miez BM şi densitatea de curent J se aleg în funcţie de puterea aparentă de calcul S.

Tabelul 2.11-2. Determinarea inducţiei în miez BM şi densităţii de curent J
S (W) | <100 | 100÷600 | 600÷1000 | 1000÷2500 | 2500÷6000
BM (T) | 0,8÷0,9 | 0,9÷0,95 | 0,95÷1 | 1÷1,2 | 1,2÷1,3
J (A/mm² ) | 2,5÷4 | 2÷3 | 1,8÷2,5 | 1,6÷2,1 | 1,5÷1,9

Se alege BM =1T şi J = 3A/mm²

Secţiunea miezului SM =
50 1 3

400 4
6,65
- ·

·
- =

50 1 3

400 4
6,65
- ·

·
- =6,65· 3,27 = 21,75≅ 22cm² .

Se aleg tole de tip E cu a=50mm.

5. Numărul de spire al înfăşurărilor

Numărul de spire al înfăşurărilor este determinat de tensiunea înfăşurării şi numărul de spire pe volt.

ns/v =
- 2 · f · BM · S M

1
π

=
1,41 50 1 0.0022

1
π · | · | · ·

= 2 spire/volt.

66 | Proiectarea circuitelor electronice de audiofrecvenţă

Numărul de spire al primarului:

n1 =
f B S

V
- 2 · · M · M
1 π | = V1 · ns/v = 220 · 2 = 440 spire

Numărul de spire al înfăşurării secundare pentru etajul final:
n2f = 2 x V2f· ns/v = 2 x 0,707·27·2 = 2 x 19·2 = 2 x 38 spire

Numărul de spire al înfăşurării secundare pentru preamplificator şi etajele intermediare:
n2p = V2p· ns/v = 22,5·2 = 45 spire
6. Secţiunile şi diametrele conductoarelor

Secţiunea conductorului din înfăşurarea primară este

SC1 =
J

I1
=
3

2
= 0,66mm²

Diametrul conductorului din înfăşurarea primară este

DC1 =
π

4 SC1

·
= 0,91mm. Se alege DC1 = 0,9mm.

Secţiunea conductorului din înfăşurarea secundară pentru etajul final este

SC2f =
J

I 2 f
=
3

9,5
= 3,16mm²

Diametrul conductorului din înfăşurarea secundară pentru etajul final este

DC2f =
π

4 SC2 f

·
= 1,99mm. Se alege DC2f = 2mm.

Secţiunea conductorului din înfăşurarea secundară pentru preamplificator şi etajele intermediare este

SC2p =
J

I 2 p
=
3

0,03
= 0,01mm²

Diametrul conductorului din înfăşurarea secundară pentru etajul final este

DC2p =
π

4 SC2 p

·
=0,11mm. Se alege DC2p = 0,12mm.

### 2.12 SCHEMA ELECTRICĂ ŞI LISTA COMPONENTELOR

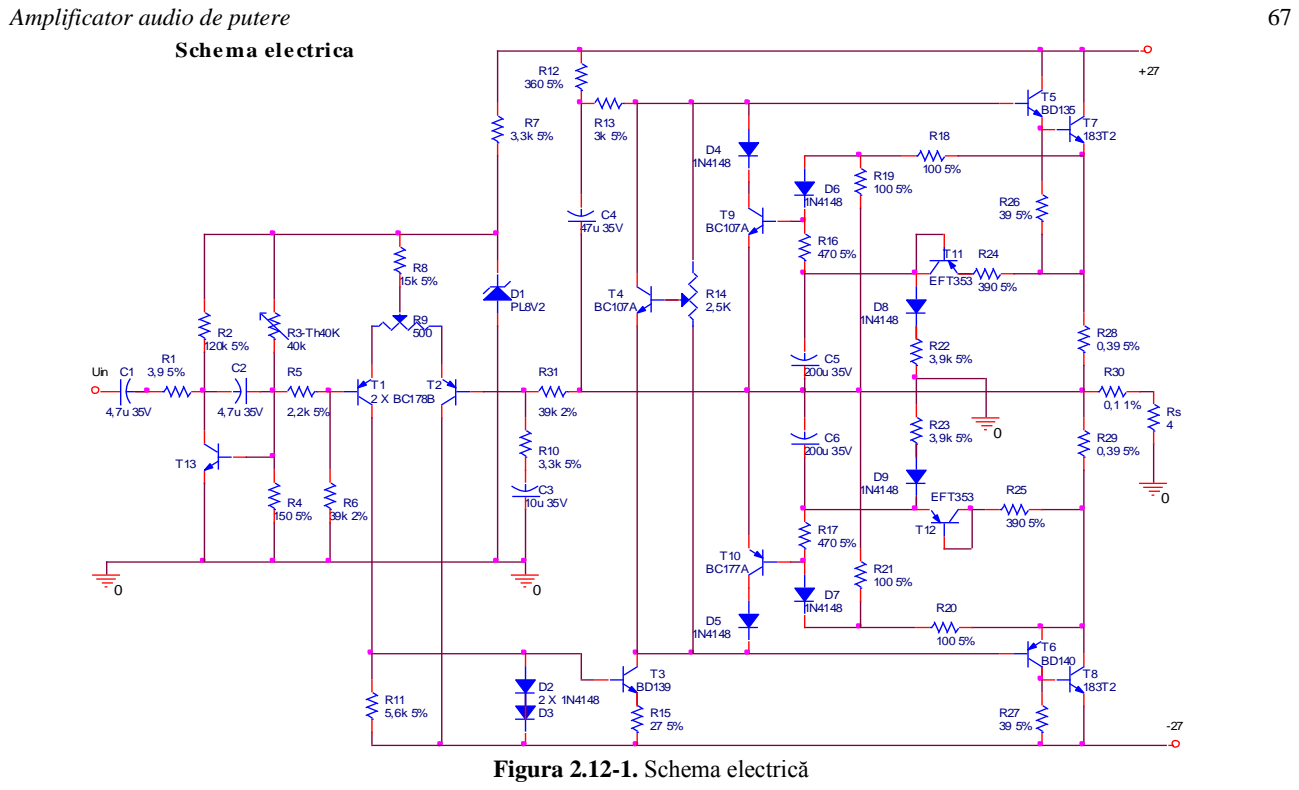
[picture p53: page 45]

68 | Proiectarea circuitelor electronice de audiofrecvenţă

Lista componentelor amplificatorului

Rezistenţe

R1=3,9KΩ, 5% | R2 = 120KΩ, 5%
R3 = Th, 40KΩ | R4 = 150Ω, 5%
R5 = 2,2KΩ, 5% | R6 =39KΩ, 2%
R7 = 3,3KΩ, 5% | R8 = 15KΩ, 5%
R9 = 500Ω | R10 = 3,6KΩ, 5%
R11 = 5,6KΩ, 5% | R12 = 360Ω, 5%
R13 = 3KΩ, 5% | R14 = 2,5KΩ
R15 = 27Ω, 5% | R16 = 470Ω, 5%
R17 = 470Ω, 5% | R18 = 100Ω, 5%
R19 = 100Ω, 5% | R20 = 100Ω, 5%
R21 = 100Ω, 5% | R22 = 3,9KΩ, 5%
R23 =3,9KΩ, 5% | R24 = 390Ω, 5%
R25 = 390Ω, 5% | R26 = 39Ω, 5%
R27 = 39Ω, 5% | R28 = 0,39Ω /3W
R29 = 0,39Ω/3W | R30 = 0,1Ω/2W

R31 = 39KΩ, 2%

Condensatori

C1 = 4,7μF/35V | C2 = 4,7μF/35V
C3 = 10μF/35V | C4 =47μF/35V
C5 = 200μF/35V | C6 = 200μF/35V

Amplificator audio de putere | 69

Tranzistori

T1 = BC 178B | T2 = BC 178B
T3 = BD 139 | T4 = BC 107A
T5 = BD 139 | T6 = BD 140
T7 = BDY 26 (183T2) | T8 = BDY 26 (183T2)
T9 = BC 107A | T10 = BC 177A
T11 = EFT 353 | T12 = EFT 353

Diode

D1 = PL 8V2 | D2 ÷ D9 = 1N4148

EC = 27V

Lista componentelor sursei de alimentare

Condensatori

C1 = 6800μF / 63V | C2 = 6800μF / 63V
Transformator monofazat | Punte redresoare
V2 = 2 x19Vef | 20PM1

I2 = 2A
