laraamy16/Audio-Power-Amplifier/Proiect docs/AAP.pdf

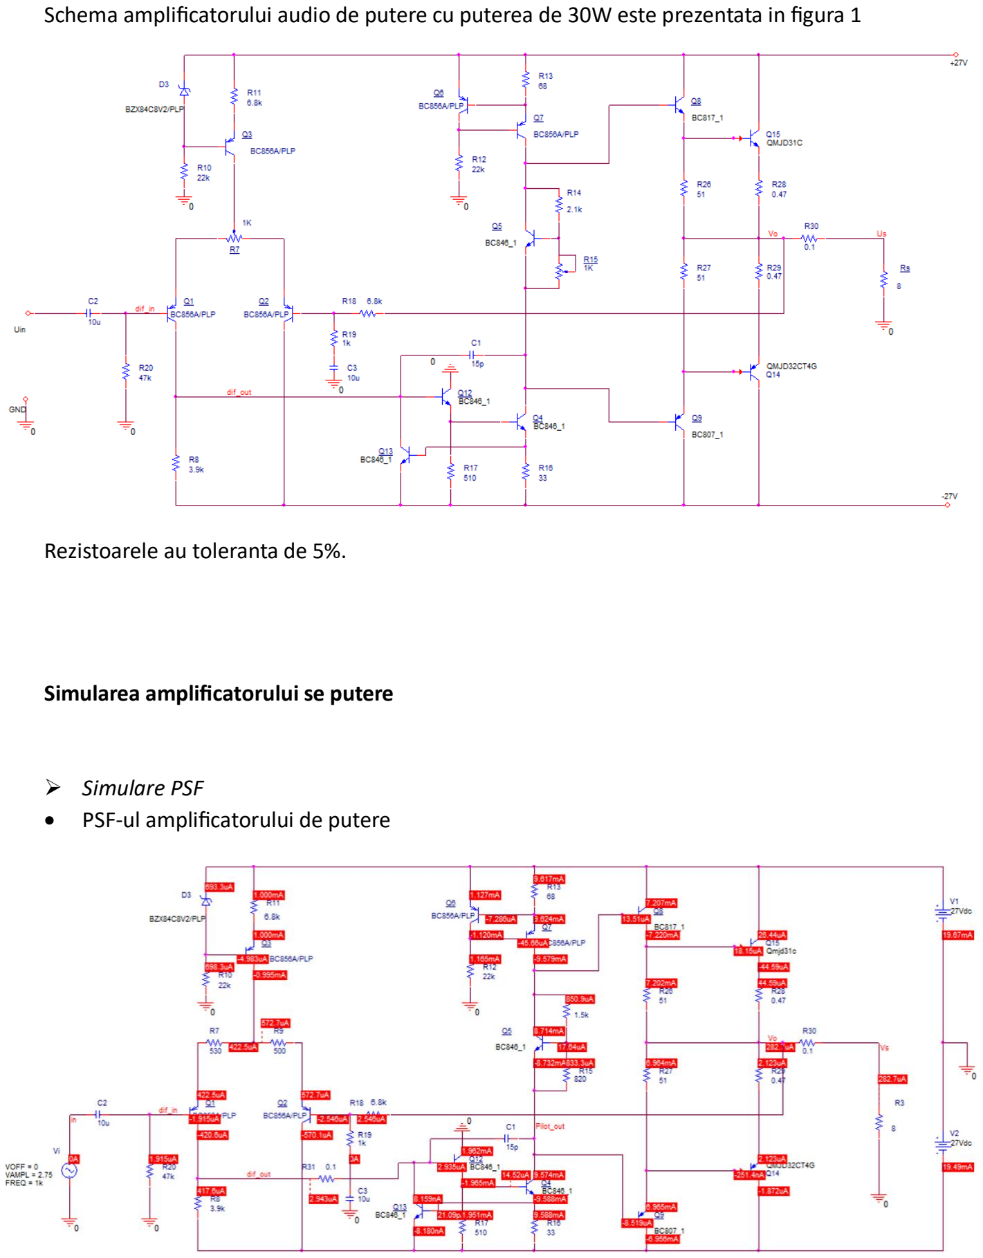
[picture p54: page 1]

Schema amplificatorului audio de putere cu puterea de 30W este prezentata in figura 1

Rezistoarele au toleranta de 5%.

Simularea amplificatorului se putere

- Simulare PSF
- PSF-ul amplificatorului de putere

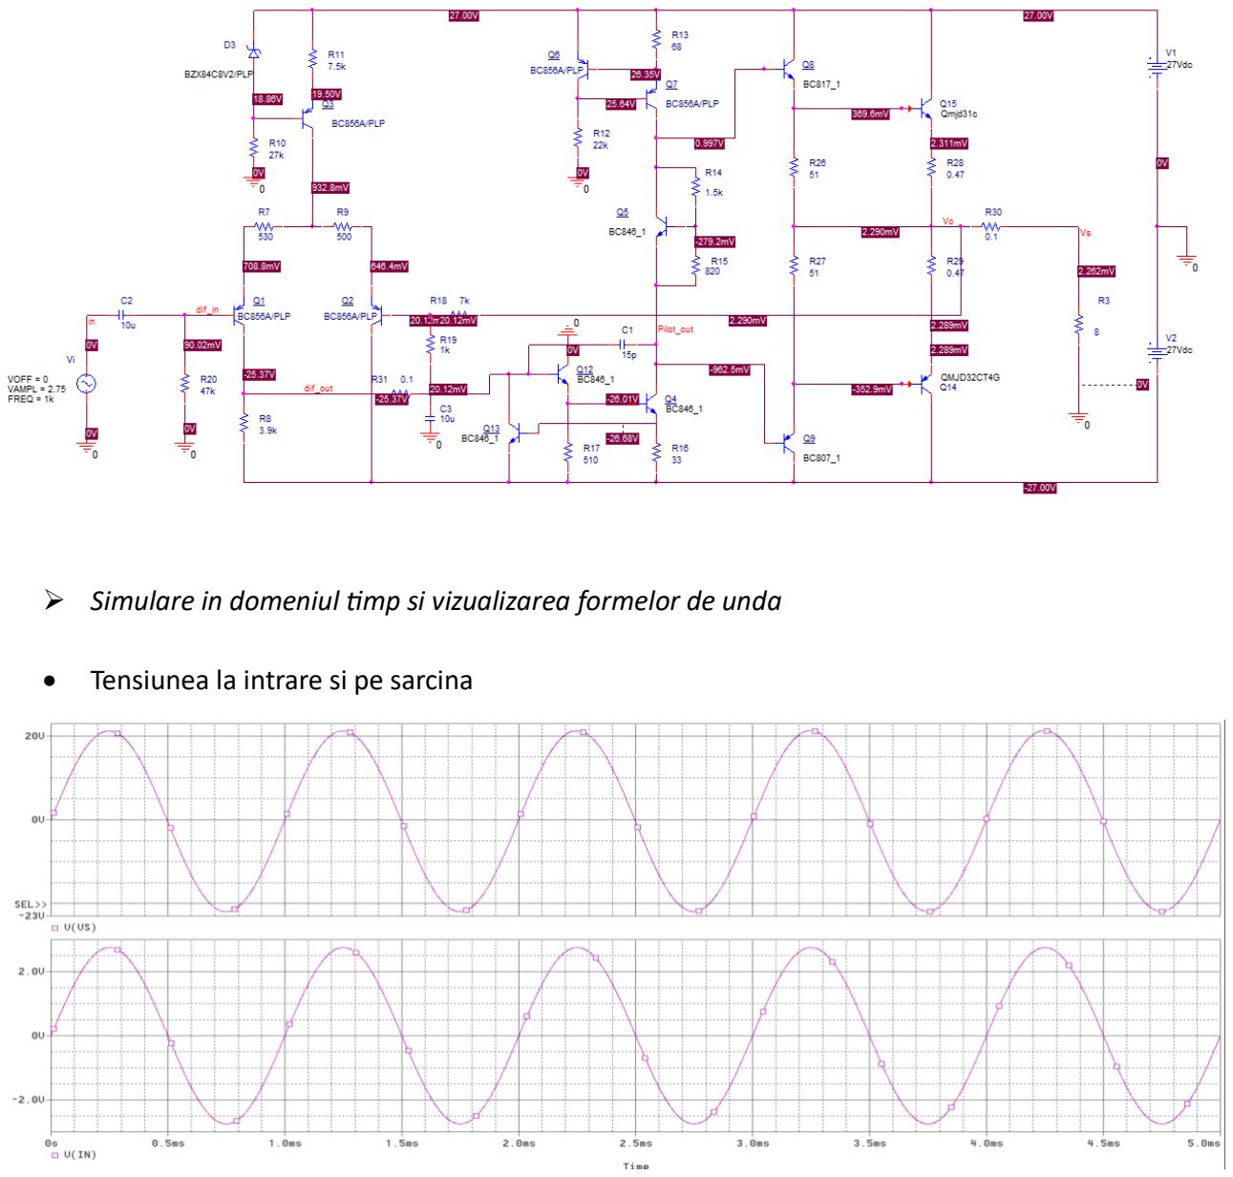
[picture p55: page 2]

- Simulare in domeniul timp si vizualizarea formelor de unda
- Tensiunea la intrare si pe sarcina

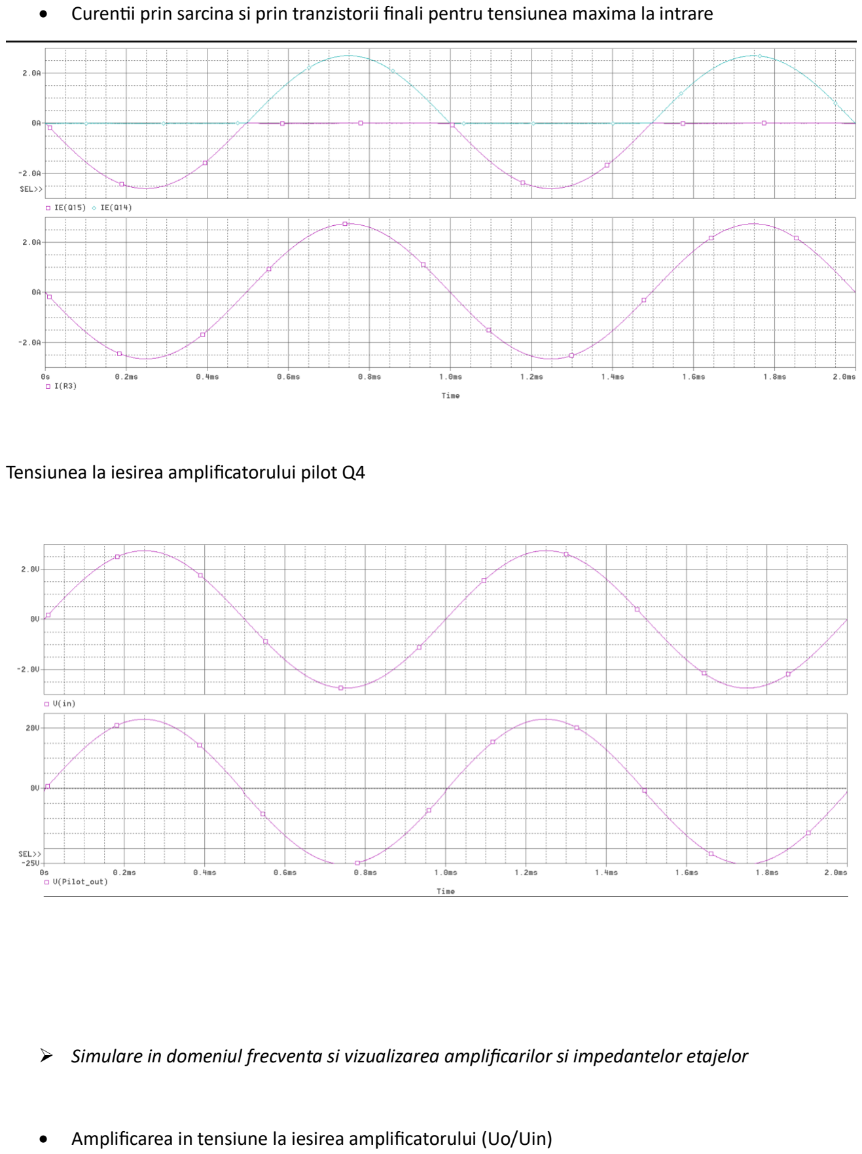
[picture p56: page 3]

- Curentii prin sarcina si prin tranzistorii finali pentru tensiunea maxima la intrare

Tensiunea la iesirea amplificatorului pilot Q4

- Simulare in domeniul frecventa si vizualizarea amplificarilor si impedantelor etajelor
- Amplificarea in tensiune la iesirea amplificatorului (Uo/Uin)

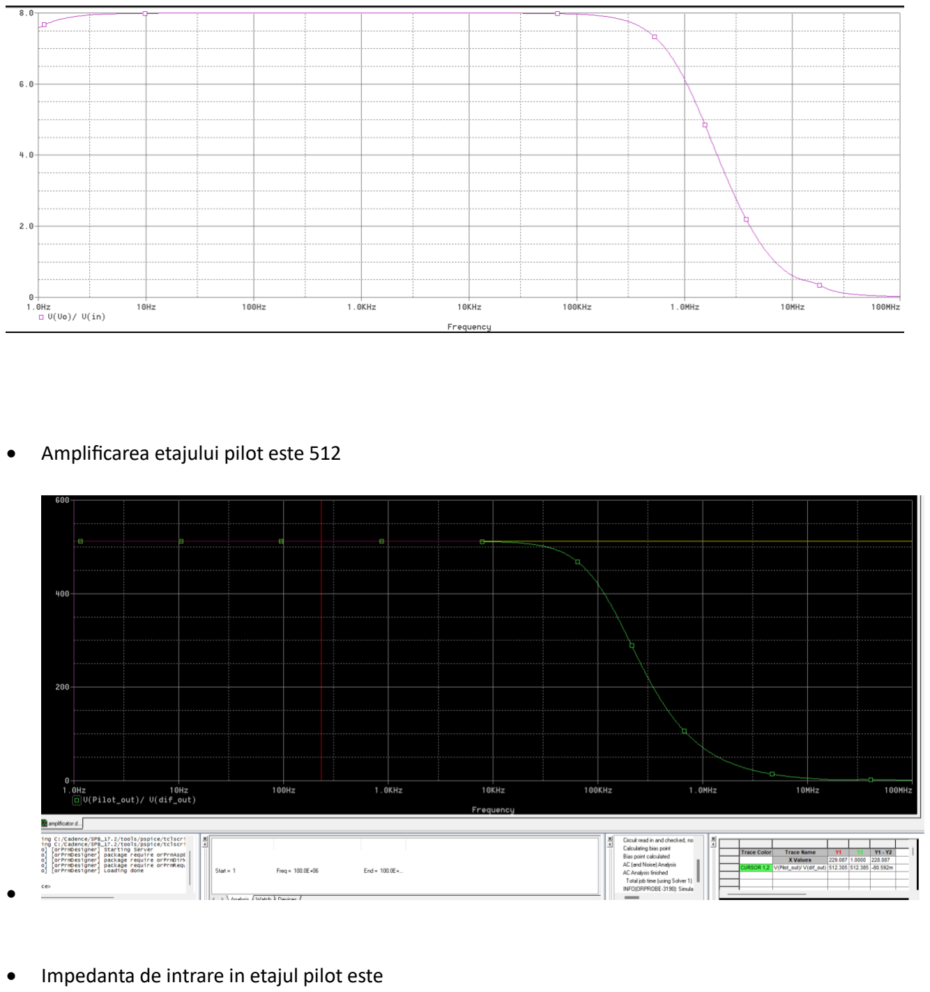
[picture p57: page 4]

- Amplificarea etajului pilot este 512

•

- Impedanta de intrare in etajul pilot este

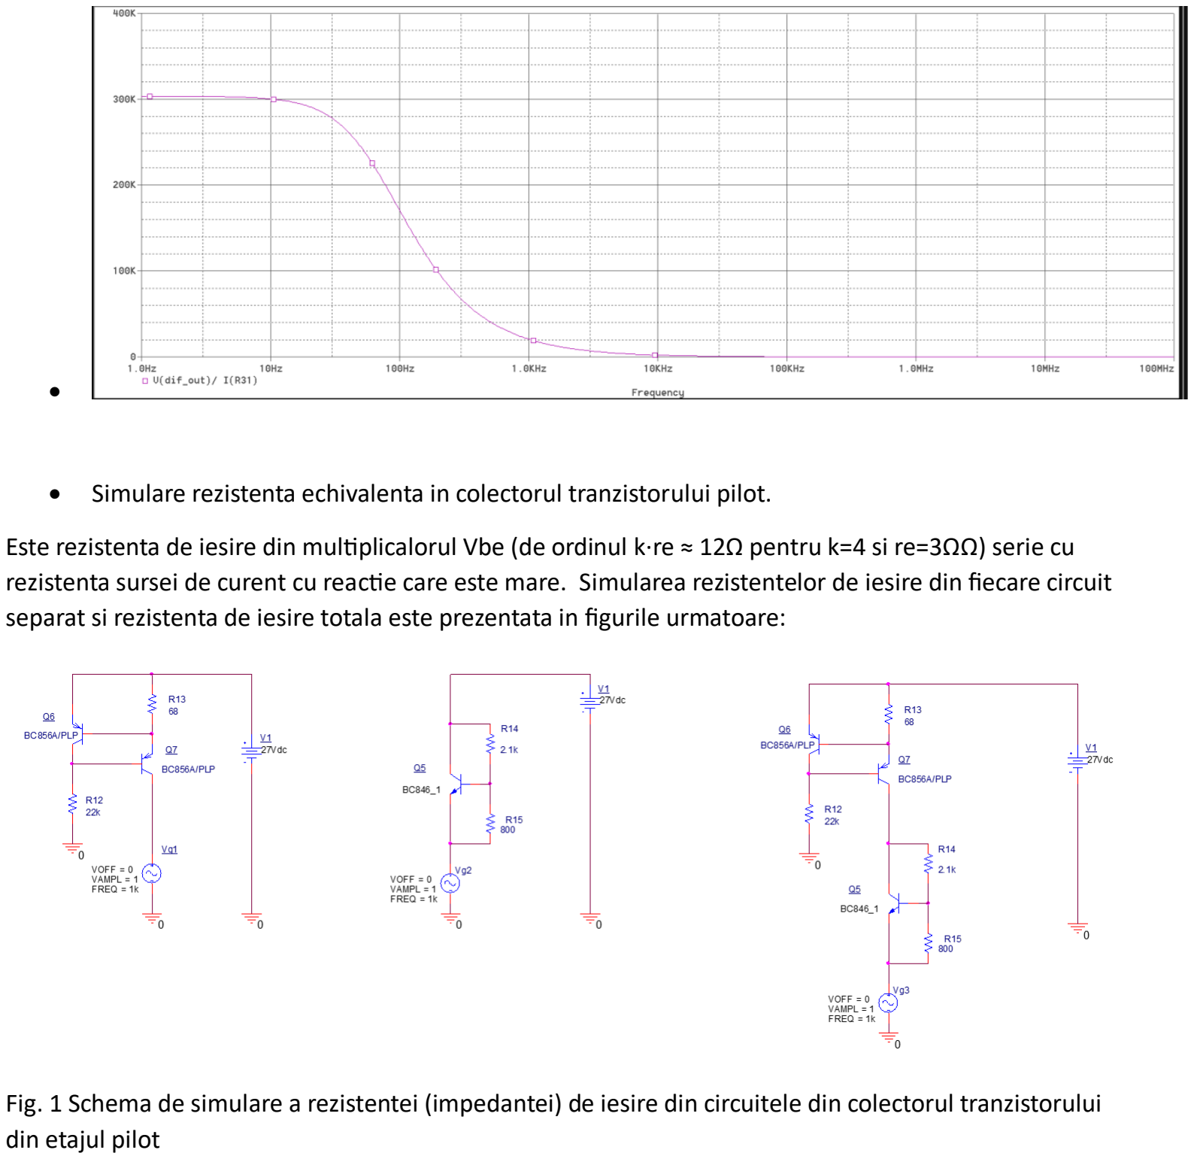
[picture p58: page 5]

•

- Simulare rezistenta echivalenta in colectorul tranzistorului pilot.

Este rezistenta de iesire din multiplicalorul Vbe (de ordinul k·re ≈ 12Ω pentru k=4 si re=3ΩΩ) serie cu rezistenta sursei de curent cu reactie care este mare. Simularea rezistentelor de iesire din fiecare circuit separat si rezistenta de iesire totala este prezentata in figurile urmatoare:

Fig. 1 Schema de simulare a rezistentei (impedantei) de iesire din circuitele din colectorul tranzistorului din etajul pilot

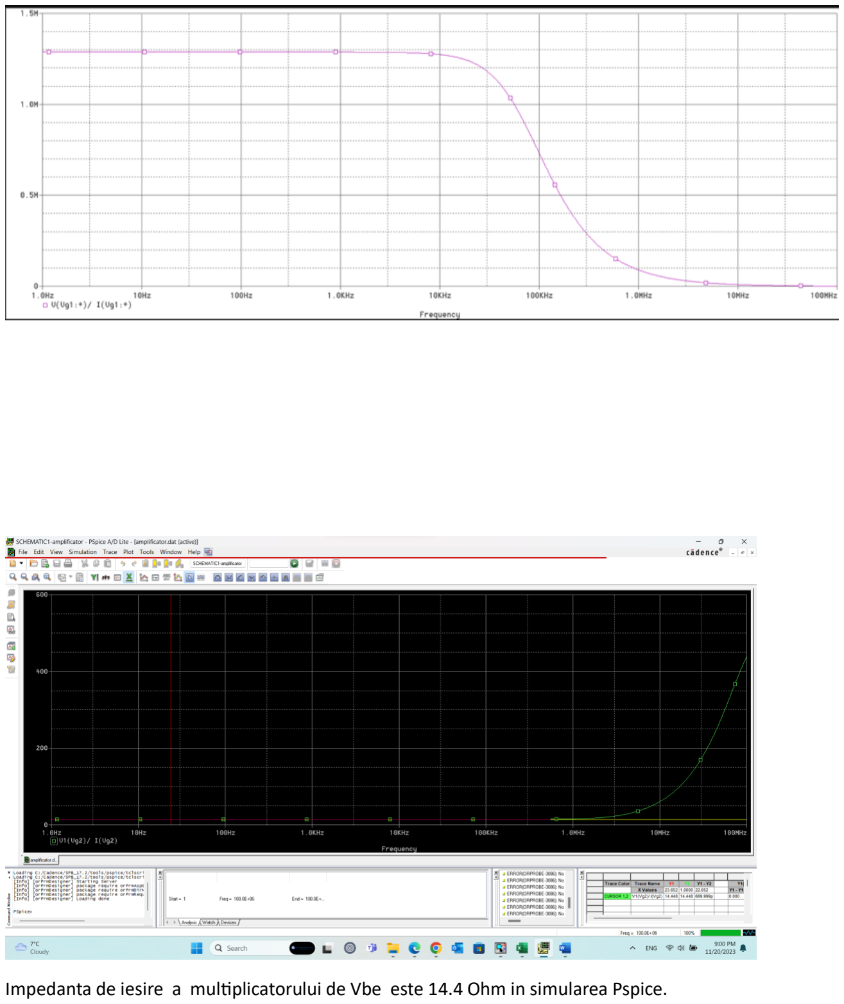
[picture p59: page 6]

Impedanta de iesire a multiplicatorului de Vbe este 14.4 Ohm in simularea Pspice.

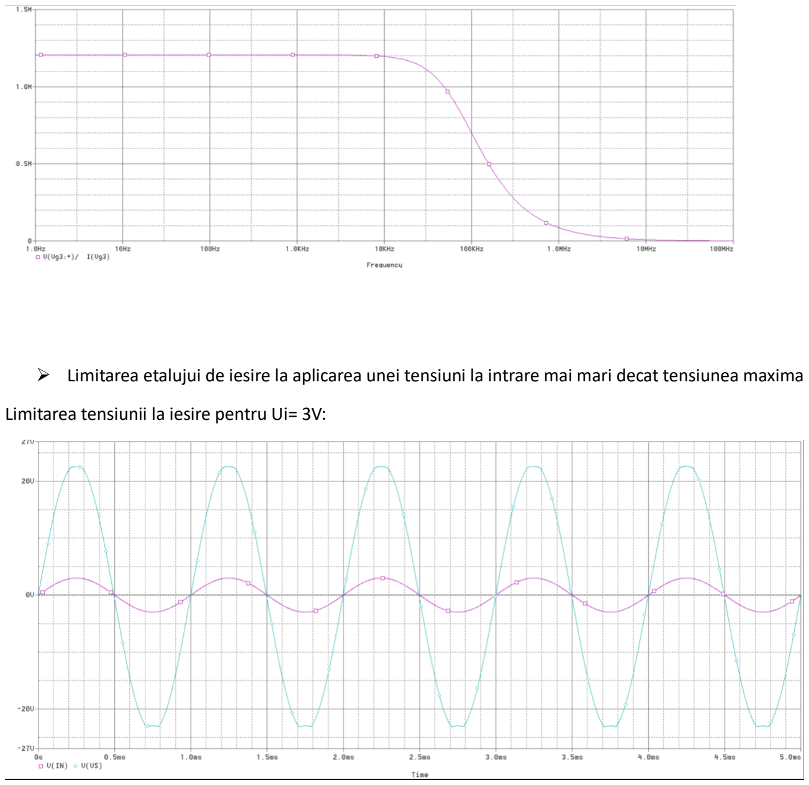
[picture p60: page 7]

- Limitarea etalujui de iesire la aplicarea unei tensiuni la intrare mai mari decat tensiunea maxima

Limitarea tensiunii la iesire pentru Ui= 3V:

Limitarea tensiunii si a curentului prin sarcina pentru Ui= 3V:

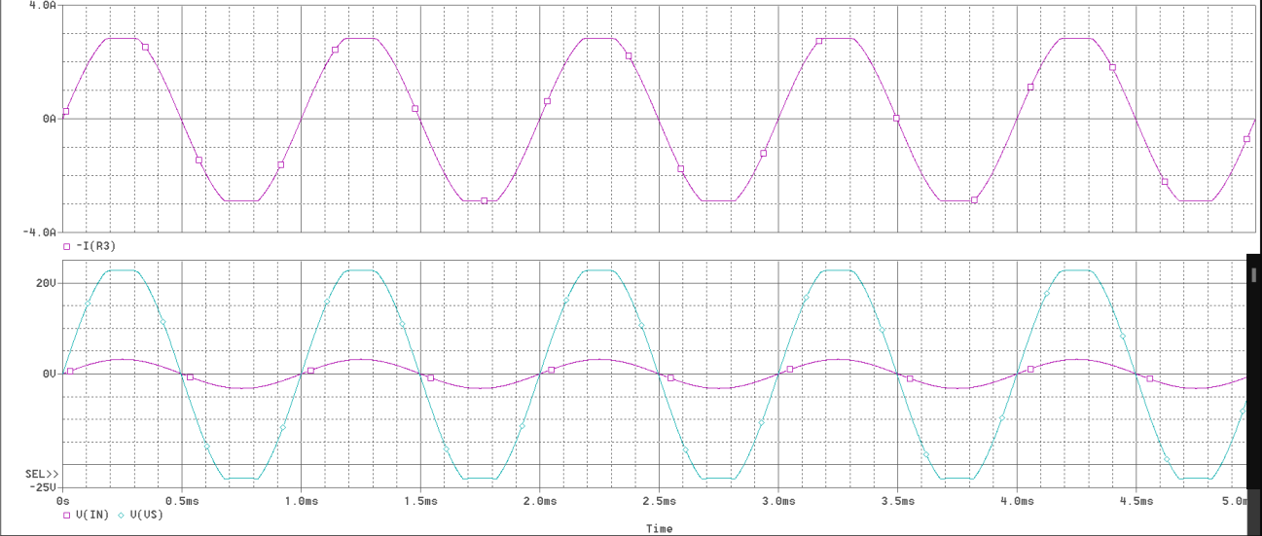
[picture p61: figure]

Bibliografie:

- „Etaje componente ale C.I. analogice. Amplificatorul diferential”- Adrian Sorin Mirea
- „Designing Audio Power Amplifiers ” -Bob Cordell
- https://electronics.stackexchange.com/questions/529475/design-a-class-ab-audio-amplifier
- https://ukdiss.com/examples/class-ab-audio-amplifier.php
- https://eng.libretexts.org/Bookshelves/Electrical_Engineering/Electronics/Book%3A_Semiconductor_Devices_-
_Theory_and_Application_(Fiore)/09%3A_BJT_Class_B_Power_Amplifiers/9.2%3A_The_Class_B _Configuration (https://eng.libretexts.org/Bookshelves/Electrical_Engineering/Electronics/Book%3A_Semiconductor_Devices_-_Theory_and_Application_(Fiore)/09%3A_BJT_Class_B_Pow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)
