laraamy16/Audio-Power-Amplifier/Schema_bloc.jpg

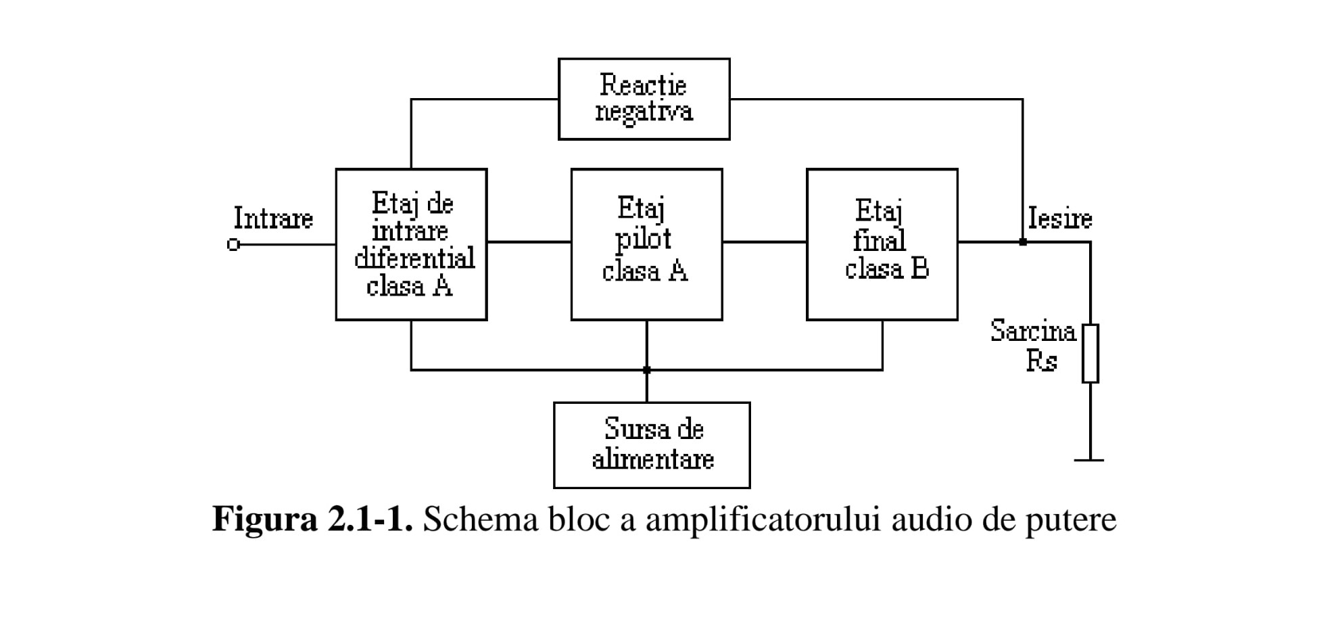
Schema_bloc.jpg
