laraamy16/Audio-Power-Amplifier/Schematics/schema_de_simulare.jpg

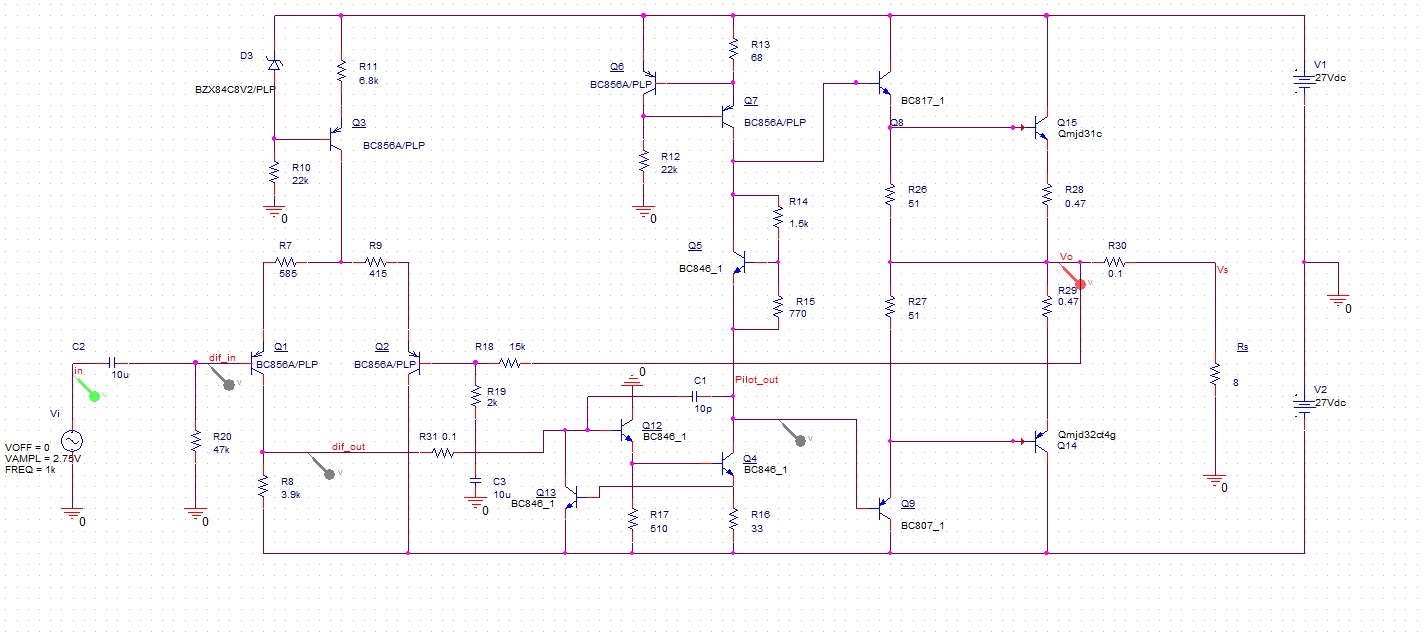
Schematics/schema_de_simulare.jpg
