laraamy16/Audio-Power-Amplifier/Schematics/schema_reala.jpg

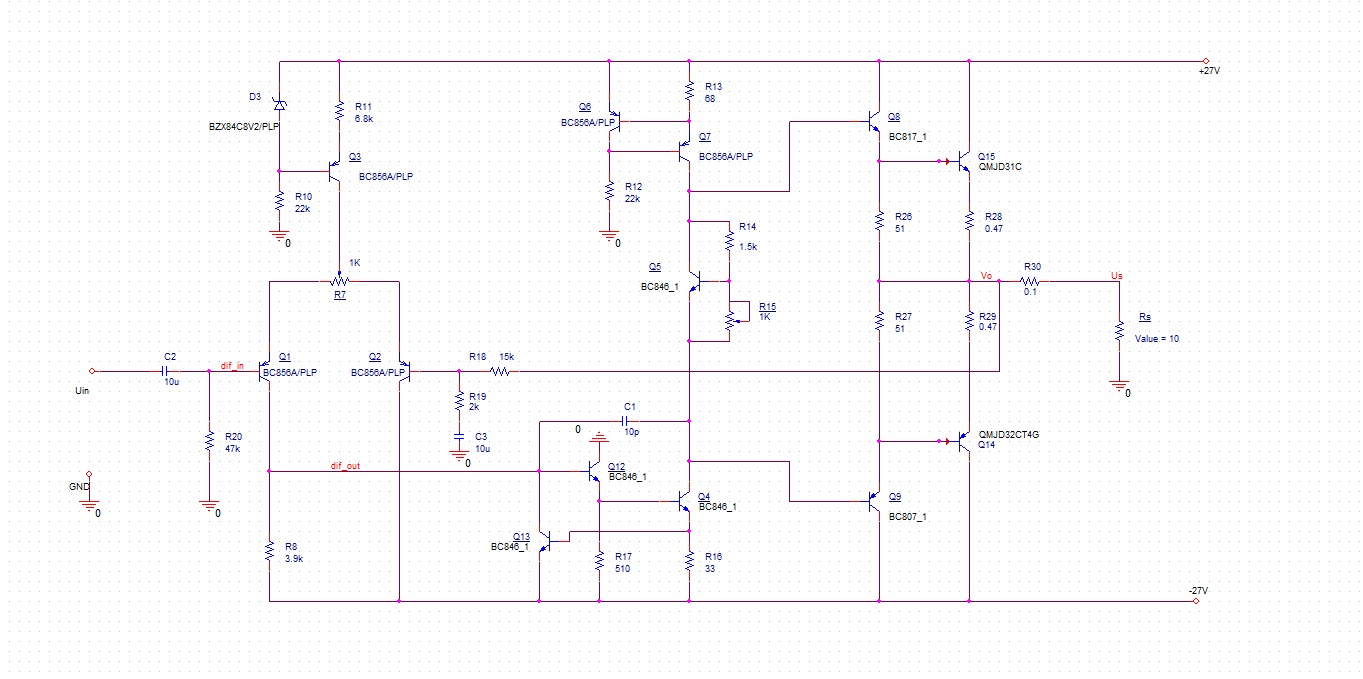
Schematics/schema_reala.jpg
