laraamy16/Audio-Power-Amplifier/Simulations/PSF.jpg

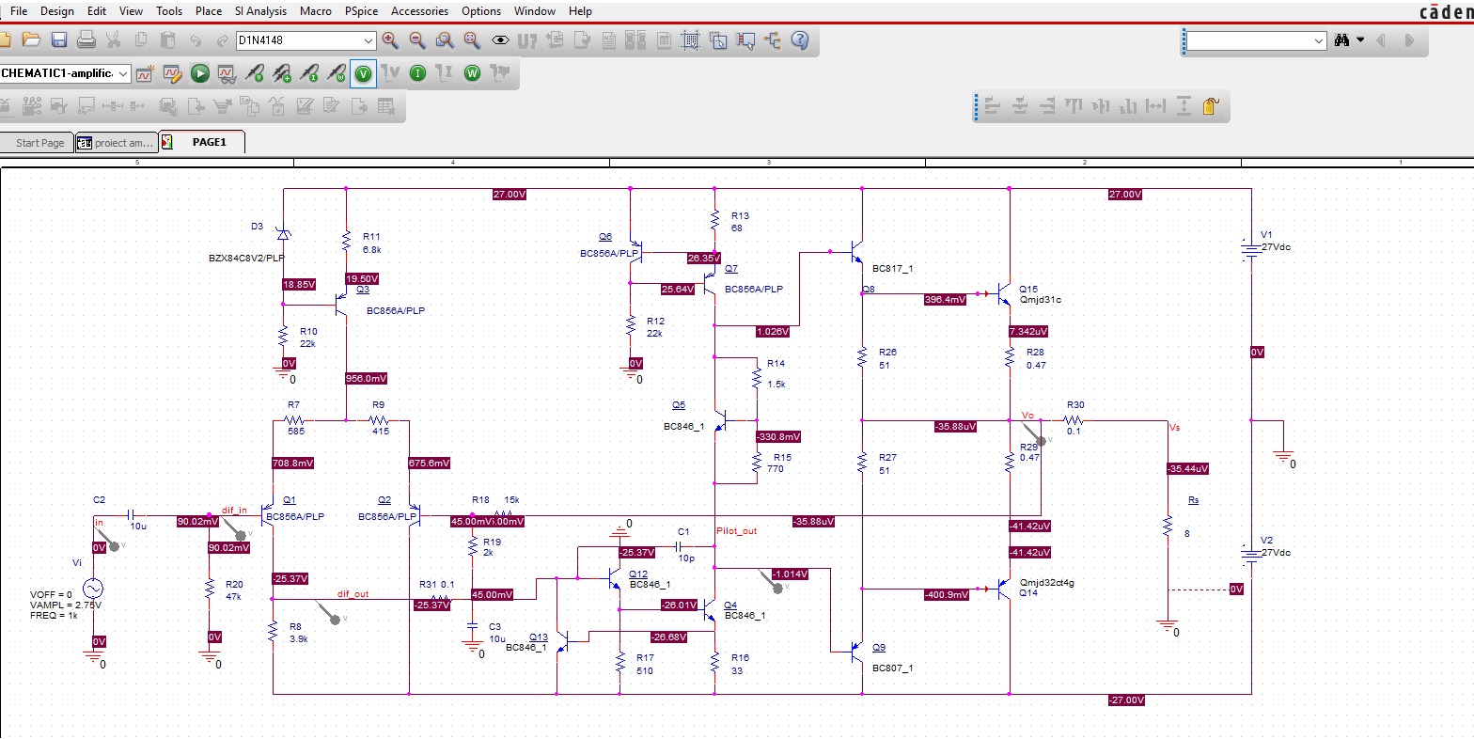
Simulations/PSF.jpg
