laraamy16/Audio-Power-Amplifier/Simulations/simulare_AC_sweep.jpg

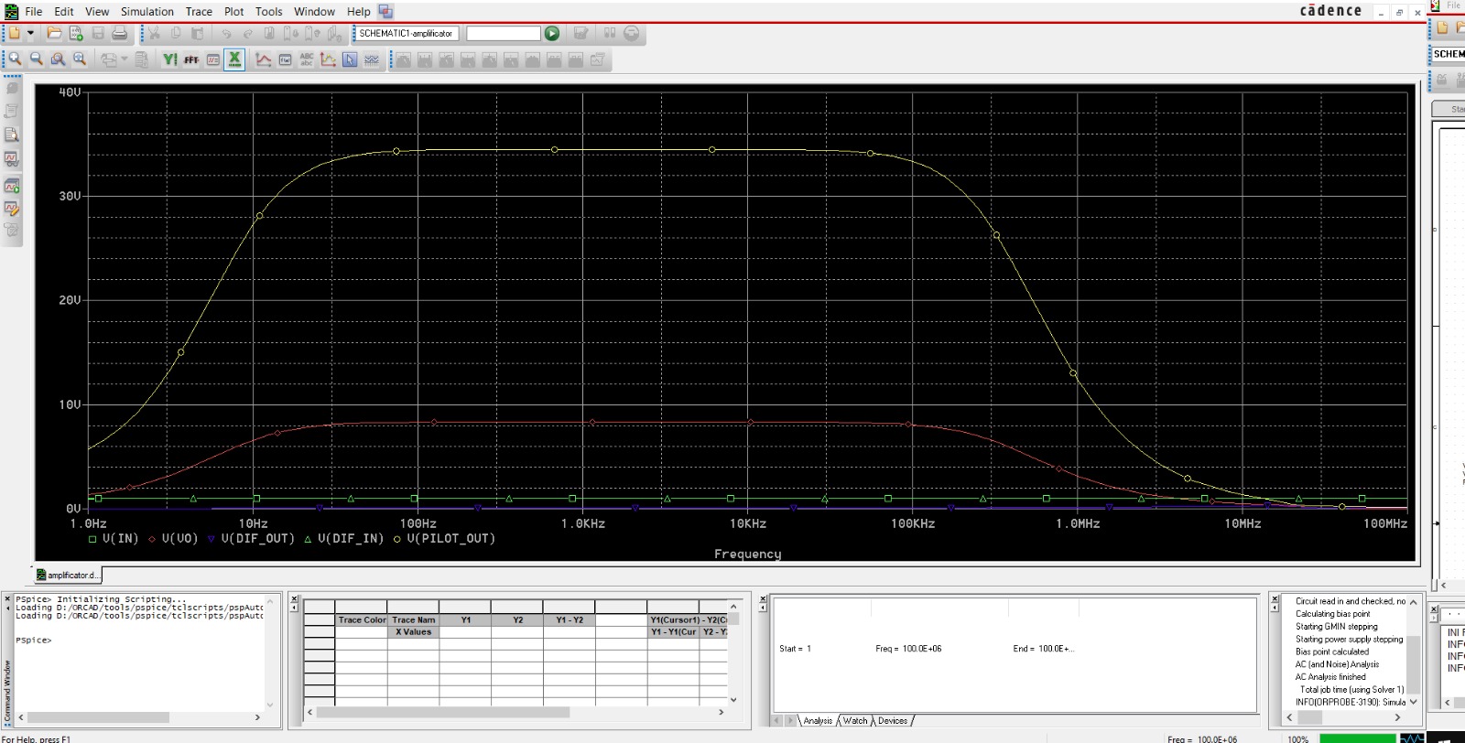
Simulations/simulare_AC_sweep.jpg
