laraamy16/Audio-Power-Amplifier/Simulations/Time_domain.jpg

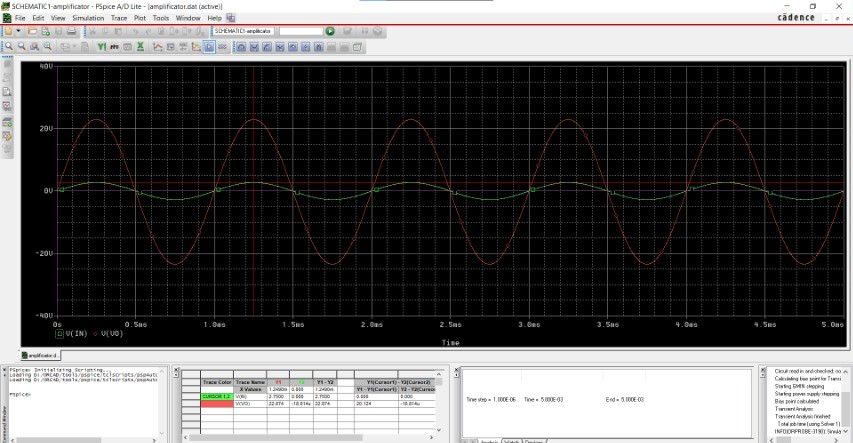
Simulations/Time_domain.jpg
