laraamy16/Audio-Power-Amplifier/Layout/FAB/DrawingFiles/Amplificator Cioc Amelia 4cm.dxf

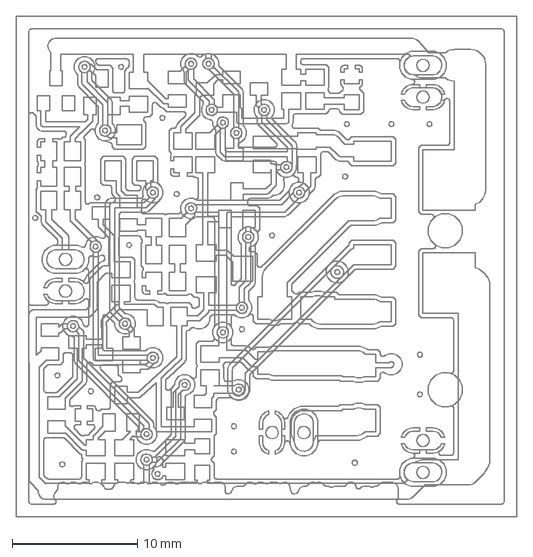
[picture p68: CAD file, 2024-03-04]
Layout/FAB/DrawingFiles/Amplificator Cioc Amelia 4cm.dxf
40.0 x 40.0 mm
