laraamy16/Audio-Power-Amplifier/Schematics/schema reala-PSpiceFiles/SCHEMATIC1/amplif putere1/amplif putere1.cir

** Profile: "SCHEMATIC1-amplif putere1"  [ c:\users\amy\desktop\facultatea masii\proiect amelia\proiect amelia-pspicefiles\schematic1\amplif putere1.sim ] 

** Creating circuit file "amplif putere1.cir" 
** WARNING: THIS AUTOMATICALLY GENERATED FILE MAY BE OVERWRITTEN BY SUBSEQUENT SIMULATIONS

*Libraries: 
* Profile Libraries :
* Local Libraries :
* From [PSPICE NETLIST] section of C:\Users\Amy\AppData\Roaming\SPB_16.6\cdssetup\OrCAD_PSpice/16.6.0/PSpice.ini file:
.lib "nomd.lib" 

*Analysis directives: 
.TRAN  0 5m 0 10u 
.OPTIONS ADVCONV
.PROBE64 V(alias(*)) I(alias(*)) W(alias(*)) D(alias(*)) NOISE(alias(*)) 
.INC "..\SCHEMATIC1.net" 


.END
