laraamy16/Audio-Power-Amplifier/Schematics/schema reala-PSpiceFiles/SCHEMATIC1/Amplif/Amplif.cir

** Profile: "SCHEMATIC1-Amplif"  [ C:\USERS\BOGDAN\DESKTOP\Proiect Amelia-PSpiceFiles\SCHEMATIC1\Amplif.sim ] 

** Creating circuit file "Amplif.cir" 
** WARNING: THIS AUTOMATICALLY GENERATED FILE MAY BE OVERWRITTEN BY SUBSEQUENT SIMULATIONS

*Libraries: 
* Profile Libraries :
* Local Libraries :
* From [PSPICE NETLIST] section of C:\OrCAD\OrCAD_10.5\tools\PSpice\PSpice.ini file:
.lib "nom.lib" 

*Analysis directives: 
.DC LIN V_V3 -5 5 0.01 
.PROBE V(alias(*)) I(alias(*)) W(alias(*)) D(alias(*)) NOISE(alias(*)) 
.INC "..\SCHEMATIC1.net" 


.END
